takarakasai/namiashi-runner2/doc/motor_map.md

# モータ / ポート対応表

`robots/namiashi.toml` の内容をそのまま表にしたもの。**校正で値が変わったら
`misa-run check` の出力が最新**（あちらは設定から毎回生成している）。ここは
ベンチで手元に置く紙の代わり。

## CH348 の UART 割り当て

`nm_board/ch348/spec_rev2_0_0_asbuilt.md` §4 の as-built 確定値。

| UART | 役割 | I/F | コネクタ |
|:--:|---|---|---|
| 0 | LEG1 = **FL** | RS485 (U9) | J14 (1=B, 2=A) |
| 1 | LEG2 = **RL** | RS485 (U10) | J15 |
| 2 | LEG3 = **FR** | RS485 (U11) | J16 |
| 3 | LEG4 = **RR** | RS485 (U12) | J17 |
| 4 | ARMA（腕） | RS485 (U13) / TTL 切替 | J18 + CN3 |
| 5 | IMU | TTL 直結 | CN1 (1=+3.3V, 2=GND, 3=TX, 4=RX) |
| 6 | S.BUS | 反転 TTL (U15)、**受信専用** | CN2 (1=GND, 2=+5V, 3=RX) |
| 7 | ARMB（予備） | RS485 (U14) / TTL 切替 | J19 + CN4 |

> **訂正 (2026-08-21):** 本表は 2026-08-20 まで UART1=FR / UART2=RL と書いて
> いたが誤り。実機は **UART1=RL / UART2=FR**。articara で実測角を可視化し、
> 脚を手で動かして対応を突き合わせて判明した（`viz_live.md`）。
>
> J14..J17 が左列 → 右列に並ぶ基板なので、**左 2 本（FL, RL）を先に配線するのが
> 自然な取り回し**になる。コード側の既定値もこれに合わせた。
>
> **`LegSlot::ALL`（FL, FR, RL, RR）とは順序が違う**点に注意。あちらは
> `quadruped_gait::LegId::ALL` と一致させる必要があり `JointVec` の添字にも
> なっているので、UART 割り当てを位置で振ってはいけない。

**`/dev/ttyCH9344USB*` の番号は当てにしない。** 列挙順で決まるので物理 UART
番号とは無関係。アプリは ch9344 の `GETUARTINDEX` ioctl で引いている
（`misa-run ports` で対応が見える）。

## 脚モータ 12 軸（LKMTech MG4005）

共通: RS485 **2,000,000 baud** / torque_constant 未設定
（＝トルク API は電流 A のまま流れる）

**減速比は軸で違う。** hip / thigh は MG4005 内蔵の **10.0**、
**calf だけベルト駆動でプーリの歯数比 28:18 が上乗せされ、総減速比 15.5556**。
脚のなかで一番負荷がかかる軸なのでそう設計されている。
設定では `MotorConfig::gear_ratio` に軸個別で持つ（未指定なら共通値）。

> **歯数から計算すること。** 28/18 = 1.5555… を 1.55 と丸めると 0.36% ずれ、
> calf の端（±2.6 rad）で約 0.5° になる。歯数は整数で誤差が無いので、
> コード側も `CALF_PULLEY_TEETH = (28.0, 18.0)` の比で持っている。
>
> **訂正 (2026-08-21):** 当初 1.47（総減速比 14.7）としていたが誤り。
> 正しくは 28:18。差は 5.8% で、calf を −2.79 rad と読んでいた場合の
> 真値は −2.64 rad（**8.8° の違い**）。それ以前に採った calf の読み値は
> すべてこの分ずれている。

**符号（`sign`）は全軸 +1 ではない。**

| | hip (Roll) | thigh (Pitch) | calf (Pitch) |
|---|:--:|:--:|:--:|
| FL | +1 | +1 | +1 |
| RL | **−1** | +1 | +1 |
| FR | +1 | **−1** | **−1** |
| RR | **−1** | **−1** | **−1** |

**Roll は前後で、Pitch は左右で反転する。** 反転の軸が違うので、
左右対称だろうと決めてかかると外す。

**独立した 3 つの根拠が一致している**（2026-08-22 時点）:

1. 設計データ
2. 実機での目視確認（両後脚の Roll が逆、右脚 2 本の Pitch が逆）
3. `calib move` で 12 軸を 1 軸ずつ 5° 動かした実測（段階 5）

> **`calib move` は可動域の端にいると使えない。** 目標は可動域へクランプ
> されるので、端の外や近くにいると「5° 動かす」つもりが端まで一気に動く。
>
> 実測 (2026-08-22): RL hip が可動域の外（−75.9°、min は −60°）にいたため、
> 5° の指令が **15.9° の移動**になった。しかも「+ 方向へ動いたか」への答えは
> クランプの結果であって符号の証拠にならないのに、そのまま採用されかけた。
> 手で内側へ戻してやり直したところ、期待どおり −1 が出た。
>
> **Δ が 5.00° でなければ結果を捨てること。** 他 11 軸はすべて 5.00° だった。

> **訂正 (2026-08-21):** 本表は 2026-08-20 まで **1,000,000 baud** と書いていたが誤り。
> 実機は **2 Mbps**。初通電時の id スキャンが 4 脚とも「応答なし」になり、
> 電源・A/B 極性を疑って切り分けた末に判明した。
> 2 Mbps に直したところ 4 脚とも即座に `id 1, 2, 3` が応答した。

| # | 脚 | UART | コネクタ | 関節名 | kind | **RS485 id** | 可動域 [rad] | URDF effort [N·m] |
|---|---|:--:|---|---|---|:--:|---|---|
| 1 | FL | 0 | J14 | `FL_hip_joint` | hip | **1** | −0.785 … +1.05 | 1.5 |
| 2 | FL | 0 | J14 | `FL_thigh_joint` | thigh | **2** | −2.62 … +2.62 | 1.5 |
| 3 | FL | 0 | J14 | `FL_calf_joint` | calf | **3** | **−2.697 … +2.697** | 2.205 |
| 4 | RL | 1 | J15 | `RL_hip_joint` | hip | **1** | −0.785 … +1.05 | 1.5 |
| 5 | RL | 1 | J15 | `RL_thigh_joint` | thigh | **2** | −2.62 … +2.62 | 1.5 |
| 6 | RL | 1 | J15 | `RL_calf_joint` | calf | **3** | **−2.697 … +2.697** | 2.205 |
| 7 | FR | 2 | J16 | `FR_hip_joint` | hip | **1** | −1.05 … +0.785 | 1.5 |
| 8 | FR | 2 | J16 | `FR_thigh_joint` | thigh | **2** | −2.62 … +2.62 | 1.5 |
| 9 | FR | 2 | J16 | `FR_calf_joint` | calf | **3** | **−2.697 … +2.697** | 2.205 |
| 10 | RR | 3 | J17 | `RR_hip_joint` | hip | **1** | −1.05 … +0.785 | 1.5 |
| 11 | RR | 3 | J17 | `RR_thigh_joint` | thigh | **2** | −2.62 … +2.62 | 1.5 |
| 12 | RR | 3 | J17 | `RR_calf_joint` | calf | **3** | **−2.697 … +2.697** | 2.205 |

### 読むときの注意

- **id はバス内でのみ一意。** 4 バスとも `1, 2, 3` の繰り返しなので、id 単体では
  12 軸を区別できない。軸の identity は **(バス, id)** の組で、バス側が半分を
  担っている。取り違えの症状は「片脚だけ挙動がおかしい」になり、配線かソフトかの
  切り分けがしづらい。コネクタと id は必ずセットで確認すること。
- **hip の可動域は CAD から決めた運用制限**で、URDF の `<limit>` ではない。

  | 脚 | 可動域 |
  |---|---|
  | 左足 FL / RL | **−60° … +45°** |
  | 右足 FR / RR | **−45° … +60°** |

  > **メカ端まで振ってはいけない。** hip Roll のメカ端は非常に広く、そこまで
  > 振ると**ケーブルが破断しうる**。機械が止めてくれないので、ソフト側で
  > 先に止めるしかない。`calib range` で手測りするのも避けること
  > （端まで動かす作業そのものが危険）。
  >
  > **訂正 (2026-08-21):** URDF は左右が逆だった。大きさ（45° / 60°）は
  > 合っていたが割り当てが入れ替わっており、左足に右足の値が入っていた。
- ~~**`sign` と `zero_pose_rad` は全 12 軸まだ未校正**（+1.0 / 0.0 の推測値）。~~
  **`sign` は 2026-08-21 に確定**（上表、設計データ + 実機確認）。

  **`zero_pose_rad` はモデル角とモータ出力軸角のオフセット**
  （`q_model = sign * q_motor + zero_pose_rad`）。
  **12 軸すべて実機で確定済み (2026-08-22)。** hip / thigh は可動域の中心から、
  calf は突き当て位置から。設計データそのままの軸はもう無い。

  | 脚 | hip | thigh | calf |
  |---|---:|---:|---:|
  | FL | **+33.20°** | **+68.40°** | **−154.52338°** |
  | FR | **−34.11°** | **+68.35°** | **−154.52338°** |
  | RL | **+31.79°** | **+64.79°** | **−154.52338°** |
  | RR | **−31.83°** | **+63.91°** | **−154.52338°** |

  hip / thigh は**可動域の中心**から確定した (2026-08-22)。calf は突き当て基準。

  > **calf は突き当て位置が基準。** 電源 ON = 突き当て = `q_abs 0` なので、
  > オフセットは突き当ての モデル角そのもの。**可動域の下限と同じ値**になる。
  >
  > **訂正 (2026-08-21):** 当初の −160° は**二重に古い情報**で計算されていた
  > （旧減速比 14.7 + 旧突き当て角）。最新の可動域 ±154.52338° に合わせて
  > 置き直した。
  >
  > 突き当てが可動域より外側（使用範囲にマージンがある）なら、その分ずれる。

  > **thigh は前後で水平の定義が違う。可動域の都合による設計。**
  >
  > | | 水平のときのモデル角 |
  > |---|---|
  > | 前脚 FL / FR | **−π/2** |
  > | 後脚 RL / RR | **+π/2** |
  >
  > 前後の表示が π ずれていても異常ではない。**知らないと「片方が壊れている」
  > と誤診する。**
  >
  > **後脚の thigh は実機で補正した (2026-08-21)。** 水平のとき RL が +1.81、
  > RR が +1.91 と過大だったので、その分をオフセットから引いた。
  > 前脚は −1.57 で期待値どおりだったため無変更。
  > RL と RR で値が違う（53.29° / 47.57°）のは実測どおり。

  > **thigh 4 軸は可動域の中心から確定した (2026-08-22)。**
  >
  > | 脚 | 実測 min/max | 幅 | 中心 | zero_pose_rad |
  > |---|---|---|---|---|
  > | FL | −2.6214 / +2.5724 | 5.194 | −1.40° | **+68.40°** |
  > | FR | −2.5218 / +2.6651 | 5.187 | +4.11° | **+68.35°** |
  > | RL | −2.7860 / +2.3846 | 5.171 | −11.50° | **+64.79°** |
  > | RR | −2.8808 / +2.3102 | 5.191 | −16.35° | **+63.91°** |
  >
  > **前脚の左右が 0.06° で一致**（後脚は 0.88°）。手で動かした測定でこの一致は、
  > 方法が妥当であることの裏付けになる。
  >
  > **測定の前に 12 軸のマルチターンをリセットすること**（`calib clear-multiturn`
  > を伏せ姿勢で）。原点が揃っていないと軸ごとに基準が違う値になる。実際、
  > リセット前に測った FR は +72.45° で、リセット後は +68.35° と 4.1° 動いた。
  >
  > **「水平で目視」から求める方法は使わない。** articara の見た目で判断すると
  > 数度は容易にずれる。両端は物理的に決まった点なので、そちらを基準にする。
  >
  > **実測の幅は ±145° より 6〜7° 広い**（4 軸とも一貫、ばらつき 1.3° 以内）。
  > 手で押し込むと数度余分に入るためとみられる。**設定の可動域は ±145° のまま**に
  > してある。実測値まで広げると押し込んだ分まで指令できてしまう。
  >
  > **hip 4 軸をメカリミットの中心から確定した (2026-08-22)。**
  >
  > リミット出し部品を製作・取付し、メカ端まで振って測った。
  >
  > | 脚 | 実測 min/max | 幅 | 中心 | zero_pose_rad | 設計 ±34° との差 |
  > |---|---|---|---|---|---|
  > | FL | −1.9386 / +1.6264 | 204.26° | −8.94° | **+33.20°** | −0.80° |
  > | FR | −1.5968 / +1.9406 | 202.68° | +9.85° | **−34.11°** | +0.11° |
  > | RL | −2.0270 / +1.5641 | 205.75° | −13.26° | **+31.79°** | −2.21° |
  > | RR | −1.5437 / +2.0079 | 203.49° | +13.30° | **−31.83°** | −2.17° |
  >
  > **設計データの ±34° に 0.1〜2.2° で戻ってきた。** つまり
  > **8/21 の目視補正 (下記) が 10〜15° 外していた**ということ。thigh で
  > 「目視と可動域基準が 4° 食い違う」実績があり、hip も同様に疑っていたが、
  > 実際には thigh よりはるかに大きく外していた。
  >
  > **後脚の左右が 0.04° で一致**（前脚は 0.91°）。手で押し当てた測定で
  > この一致は、方法が妥当であることの裏付けになる。前後で 1.85° 違うのは
  > 実測どおりで、設計は 4 軸とも同値 (±34°) としていた。
  >
  > 前提は**メカ端が関節ゼロについて対称**であること。設計値と一致したことが
  > その裏取りになっている。
  >
  > **メカ端は新フレームで ±101〜103°。** 運用制限 (CAD の左 −60…+45° /
  > 右 −45…+60°) までの余裕は 41〜58° あり、**運用制限は変えない**。
  > メカ端まで振ってよいのはこの測定のときだけで、常用してはいけない
  > （ケーブル破断のリスク）。
  >
  > <details><summary>置き換えられた暫定値 (2026-08-21、目視基準)</summary>
  >
  > 設計データの ±34° を入れた状態で **表示が実際より過大**に見えたため、
  > 実際が 0° のとき表示が FL +0.17 / FR −0.17 / RL +0.27 / RR −0.27 rad を
  > 指しているとみなし、その分をオフセットから引いていた
  > （hip = FL +24.26° / FR −24.26° / RL +18.53° / RR −18.53°）。
  >
  > ```
  > q_model = sign * q_abs + zero_pose_rad
  > 表示が +0.17 過大 → zero_pose_rad から 0.17 を引く
  > ```
  >
  > **この判断が誤りだった。** articara の見た目で「0°」を決めたことが原因で、
  > thigh と同じ轍。**両端は物理的に決まった点なので、そちらを基準にする。**
  > </details>
  >
  > 補正量が 10〜15° と大きい。設計データの「伏せ姿勢」と、実際に電源を
  > 入れている姿勢が同じでない可能性がある。**thigh と calf は未補正**なので、
  > 同様のずれが残っているかもしれない。段階 6 の `calib zero` で 12 軸まとめて
  > 測り直すのが本筋。
  >
  > 前後で値が違う（24.26° / 18.53°）のは実機の実測どおり。左右は符号反転で対称。

  > **基準の性質が軸で違う。これが実測のずれ方を説明する。**
  >
  > | 軸 | 基準 | 再現性 |
  > |---|---|---|
  > | hip / thigh | **メカ端 2 点の中心**（`calib range`） | 機構が決めるので再現する |
  > | calf | **メカ的な突き当て**からのオフセット | 同上 |
  >
  > **3 軸とも機構が決める点を基準にしている。** 設計データの
  > 「伏せ姿勢での電源 ON」基準は、姿勢を人が作るので毎回変わり、実際に
  > hip で 10〜15°・thigh で 4〜16° ずれていた。**もう使わない。**
  > **calf の突き当て基準は触らない。**
  >
  > ### 電源 OFF/ON と「伏せ起動」
  >
  > MG4005 は**多回転**のアブソリュートを持たないので、**電源 ON した瞬間の
  > 姿勢が `0x92` のマルチターン角 0 になる**。`zero_pose_rad` はその
  > **電源投入姿勢のモデル角**であり、**毎回「伏せ姿勢」で電源を入れる**
  > という運用がそのまま回転数の解決になっている。
  > アプリの再起動では動かない — 基準はモータ側にある。
  >
  > **したがって電源を切ってもゼロ点は死なない。** 死ぬのは伏せ姿勢を
  > 再現しなかったときだけ。メカ作業で電源を落とすのは通常の運用。
  >
  > **精度は伏せ姿勢の再現性そのもの。** 今回の hip 実測が設計の伏せ姿勢
  > ±34° に対して 0.1〜2.2° に収まったので、再現性はその程度。
  > **その誤差がそのままゼロ点の誤差になる。**
  >
  > メカ端を測る方法の利点は、伏せ姿勢に頼らずに**いつでも測り直せる**こと。
  > 両端は物理的に決まった点なので、姿勢を目視で作る方法と違って再現する。
  >
  > ### `0x94`（単回転絶対角）へ移す余地
  >
  > `0x94` は ROM のエンコーダゼロが基準なので**電源をまたいで一致する**
  > （`calib single-turn` で読める）。ここへ移せば、
  >
  > - 必要な姿勢精度が「1 モータ回転の半分」まで緩む
  >   （hip/thigh **±18°**、calf **±11.6°**）
  > - 精度は姿勢の再現性ではなく**エンコーダ由来**になる
  >
  > 何回転目かの解決には依然として既知の姿勢が要るが、要求が桁違いに緩い。
  > **未着手。** 移すなら、選んだ回転が可動域に収まらないときは起動を止める
  > こと（黙って 36° ずれた姿勢で立ち上がるのが一番危ない）。

- **モータ id は設計データを採用していない。** 設計は FL 10-12 / RL 13-15 /
  FR 20-22 / RR 23-25 だが、**これは 4 バス化より前の資料**で、実機は 4 バスとも
  `1, 2, 3`（段階 2-2 のスキャンで確認）。上表のとおり 1, 2, 3 が正。

- **可動域の出所は軸で違う。**

  | 軸 | 可動域 | 出所 | `calib range` で測る？ |
  |---|---|---|---|
  | hip | 左 −60…+45° / 右 −45…+60° | **CAD**（ケーブル保護の運用制限） | メカ端は ±101〜103°。**運用では端まで振らない** |
  | thigh | **±145°**（4 軸共通） | **実測済み** | 済 |
  | calf | ±154.52338° | **設計のメカ端** | **測らない。** 手測りは必ず狭くなる |

  calf を手で測ると (a) 突き当てまで押し込めない (b) `--margin` がさらに引かれる、
  で今より狭い値になり、`start` ポーズがクランプされてしまう。

  **calf だけ可動域が違う。** 2026-08-21 の設計変更で **±154.52338°
  (±2.6969 rad)**。thigh の ±2.62 rad (±150.11°) と混ぜないこと。

  > **解消済み (2026-08-22)。全 6 ポーズが可動域内。** 段階 7-1 で
  > `.misa` の全ポーズを設定の可動域と突き合わせて確認した。
  >
  > | ポーズ | 最小余裕 | どの軸 |
  > |---|---|---|
  > | `extend_full` / `extend` / `standby` | +45.00° | hip |
  > | `constrain` | +39.93° | calf |
  > | **`start`** | **+10.00°** | 前脚 calf (−144.52°) |
  > | **`constrain_2`** | **+5.55°** | calf (−148.97°) |
  >
  > `start` の +10° はメカ端から 10° の余裕を持たせる設計方針どおり。
  > **`constrain_2` の +5.55° が一番きつい**ので、calf の可動域を今後
  > 狭めるならここが最初に引っかかる。
  >
  > かつて「前脚 calf −162° が +7.48° 超過」と記録していたが、その後
  > ポーズ側が −144.52° に更新されて解決している。

## 異常ビット（`errorState`）

マニュアル §1 の `errorState` は 1 ビットずつ意味が違い、**対処もまるで
別物**。`misa-run run` は日本語で出す（生値だけでは判断できない）。

| bit | 値 | 意味 | 対処 |
|---|---|---|---|
| 0 | `0x01` | **低電圧保護** | 電源電圧を確認。電流制限に当たっていないか |
| 1 | `0x02` | 高電圧保護 | 回生。減速を緩める |
| 2 | `0x04` | ドライバ過熱 | 冷えるまで待つ |
| 3 | `0x08` | モータ過熱 | 同上 |

**起動時に自動クリアはしない。**

> マニュアル §2: *the error flags cannot be cleared while the motor state
> has not yet returned to normal.*
>
> つまり**原因が残っている間はクリアコマンド自体が効かない**ので、自動で
> 投げても無意味。仮に効く場合でも、自動クリアは「生きている異常を握り
> 潰して動き出す」ことになる。低電圧のまま起立させればトルクが出ずに
> 崩れるか、また保護に入る。

消すのは人が原因を潰したと判断したときだけ:

```sh
./target/release/misa-run calib clear-error [--leg FL]
```

`0x9B` の応答は**「消した後の状態」**であって成功フラグではないので、
返ってきたフラグを見て判定している。

### 低電圧保護は `0x9B` で解除できる【解決】

**2026-08-22。** 段階 8 の確認中に過負荷で低電圧保護 (`0x01`) に入る事象が
複数回起きた。**結論を 5 回変えた**ので、確定した事実と、外した見立ての
理由を残す。

#### 確定した挙動

**クリアコマンド (`0x9B`) は効く。待っても消えない。**

| 時刻 | 操作 | 結果 |
|---|---|---|
| 12:18:03〜12:21:39 | **`--dry-run` のみ（3.5 分）** | **消えない** |
| 12:21:45 | **クリアを送信** | |
| 12:22:52 | `legs` | 異常ログ 1 行も無し = **消えている** |
| 12:22:58 | `--dry-run` | **12 軸すべて正常** |

電圧は終始 19.8 V。**電圧を上げる必要も、`0x07` による再起動も要らない。**
バッテリ運用でも `0x9B` で復帰できる。

#### なぜ 5 回も外したか — **表示のバグだった**

`0x9B` の応答は **「コマンドを受けた時点の状態」** を返す。マニュアル §2 は
「応答は status1 と同じ」としか書かず、消す前か後かに触れていない。
**こちらが「消した後」と決めつけて、応答をそのまま状態として保存していた。**
その結果「クリア後」に異常が残って見え、毎回モータ側の物理現象として
説明しようとした。

外した見立て（すべて根拠不足）:

1. 「電源が壊れている / 電流制限に張り付いている」→ 19.8 V は設計値
2. 「6S LiFePO4 はこのドライバでは使えない」→ **16 V でも歩けた**
3. 「フラグは現在状態で、電圧が戻れば自動で消える」
4. 「リセット閾値は 19.9〜20.9 V のヒステリシス」
5. 「時間経過で自然に解除される」→ **3.5 分待っても消えない**

**分かれ目は毎回同じ。** 「同じ電圧で正常な軸と異常な軸が混在する」
「RR thigh だけ毎回消える」という観測は**最初から表示バグを示唆していた**
（定期 status 読みが 1 秒に 1 軸ずつ巡回するので、クリア直後に当たった軸
だけが本当の状態を見せていた）。それをモータの個体差として説明し続けた。

> **自分が書いた表示を疑わなかったのが原因。** 実機の挙動が奇妙なとき、
> 観測系のバグを先に疑うこと。

対策として、**クリアを送った直後に `0x9A` で読み直す**ようにした
（`BusRequest::ClearError`）。応答は信用しない。

#### 電圧の余裕

| 電圧 | 結果 |
|---|---|
| 19.8 V | 終日正常動作（6S LiFePO4 を想定した設計値） |
| 17.6 V | 保護は出ない |
| **16 V** | **立脚まで到達し、歩容が 1 秒動いた** |

**トリップ閾値は 16 V より下。19.8 V の常用には十分な余裕がある。**

**掃引はこれ以上しない。SBC (A7Z) が同じ電源から給電されている。**
下げ続けると DC-DC が入力下限を割って SBC が落ち、SD カードを壊しうる。
制御が消えて 12 軸が脱力する方が、モータの保護よりはるかに悪い。

#### 本当の問題はストール時の突入電流

16 V でも落ちないのだから、過負荷時は**もっと深いところまで瞬間的に
沈んでいる**。脱調や突き当てでモータが大電流を引き、電源が電流制限
(5 A) に落ちてレールが崩壊する。

**復帰できることは分かったが、復帰は解決ではない。** 試合中に 12 軸が
同時にトルクを失えばその時点で倒れる。**落とさないことが目的。**

- **ストールを検知して指令を止める**（追従誤差の監視。第 1 段は実装済み、
  状態表示に `追従最大=` として出る。上限で頭打ちにする第 2 段は未実装）
- ソフト側でトルク / 速度の上限を絞る
- SBC の電源系統を分離する（**本番が近いため保留中**）

> **本番のバッテリは電流を制限しない。** 電圧は落ちにくくなるが電流は
> 青天井になるので、ストール時の発熱・損傷はむしろ悪化する。

RS485 のマニュアルに閾値を読む・書くコマンドは無い（§18/19 は PID と
加速度のみ）。

### `0x07`（モータ再起動）【実装済み・出番は無くなった】

低電圧保護が `0x9B` で解除できると分かったので、**復帰目的では要らない**。
原点を失う代償に見合わない。

以下は「電源再投入をバスから起こしたい」別の用途のために残す。

`misa-run calib restart [--leg FL] [--joint calf]` で試せる。
**必ず伏せ姿勢で。** 原点がリセットされるので、伏せ以外だと 12 軸の
ゼロ点が飛ぶ。前後の異常状態と Δq(model) を並べて出す。

**まだ実行していない。** トリップさせるには深く沈める必要があり、
SBC を巻き込むため。

> **フレームの組み方は CAN マニュアルから導けない。**
>
> | | CAN 上の見た目 | RS485 の実際 |
> |---|---|---|
> | `0x92` | `DATA[0]=0x92`, `DATA[1..7]` ヌル | `CMD[3] = 0x00`（データ無し） |
> | `0x95` | `DATA[0]=0x95`, `DATA[1..7]` ヌル | **`CMD[3] = 0x07` + ゼロ 7 バイト** |
>
> CAN では同形なのに RS485 では違う。**ここを取り違えて `0x95` で
> マルチターンカウンタを 2 回壊した**（2026-08-21）。
>
> `0x07` は `CMD[3] = 0x00` で送る。RS485 マニュアルの引数なしコマンドは
> Motor off/run/stop・状態読み・エラークリア・多回転読み・単回転読みまで
> **すべて `0x00`** で、`0x95`（§24）だけが唯一の例外。

## 可動域を逸脱したときの扱い【未解決】

**制御中に外力を受けると、上表の可動域を超えることがある。** 指令は
`min_rad`/`max_rad` にクランプされるので**こちらから超えることはない**が、
押された・転んだ場合は超えうる。

**超えた状態で脱力させるのは危険。** 特に hip は、メカ端まで余裕がある一方で
ケーブルが先に限界を迎える。脱力するとそのまま外力に任せることになり、
自力で戻れない。

現状の挙動:

| きっかけ | 挙動 | 逸脱時に安全か |
|---|---|---|
| S.BUS 受信断・フェイルセーフ | 速度 0・その場起立（**脱力しない**） | 比較的よい。姿勢を保とうとする |
| **`Ctrl-C`** | **全軸脱力** | **危うい。** 逸脱したまま力が抜ける |
| モータ電源 OFF | 脱力 | 同上 |

`Ctrl-C` の脱力は「暴走したら力を抜く」という発想で、それ自体は正しい。
しかし**逸脱時にはむしろ戻してから抜きたい**。両立させるなら、脱力の前に
可動域内へ戻す動作を挟むことになるが、暴走時にそれをやると危険が増す。
**トレードオフであり、決めきれていない。**

判断の材料になる実測がまだ無い（段階 7 以降で逸脱が実際に起きるか）。
それまでは**脚を浮かせた状態でしか運転しない**という運用で回避する。

## 腕

`arm_pitch_joint` は MG4005 ではなく RC サーボ。**受信機直結**で、アプリは
駆動しない（プロポ CH9 から角度を観測するだけ）。品種は未定。

| 項目 | 値 |
|---|---|
| 可動域 | −2.3 … +0.85 rad（URDF `<limit>`） |
| effort | 6.865 N·m |
| 観測チャンネル | S.BUS CH9（`teleop.arm`） |
