takarakasai/namiashi-runner2/sim/tests/fixtures/namiashi/meshes/calf.stl

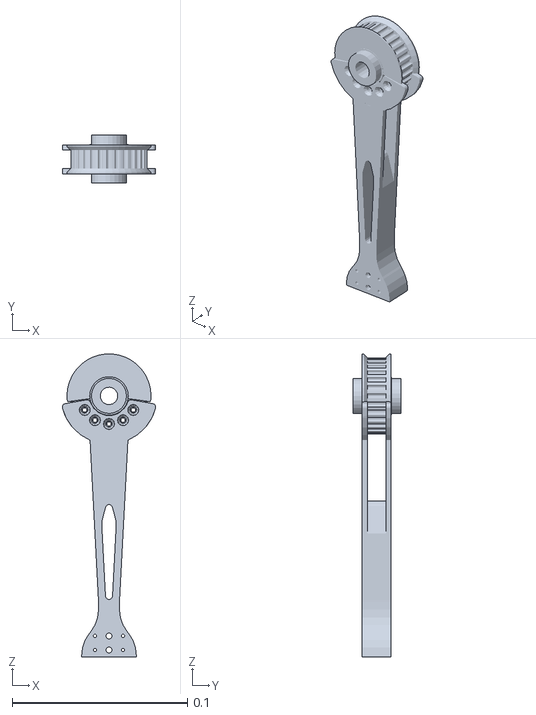
[picture p1: CAD file, 2026-09-11]
sim/tests/fixtures/namiashi/meshes/calf.stl
0.0533 x 0.0274 x 0.173
