takarakasai/namiashi-runner2/sim/tests/fixtures/namiashi/meshes/arm.stl

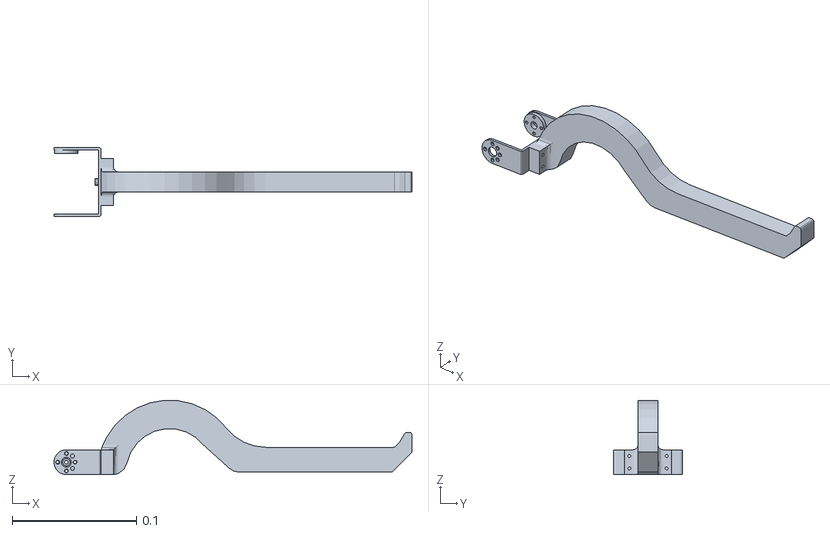
[picture p2: CAD file, 2026-09-11]
sim/tests/fixtures/namiashi/meshes/arm.stl
0.288 x 0.0556 x 0.0597
