takarakasai/namiashi-runner2/sim/tests/fixtures/namiashi/meshes/thigh.stl

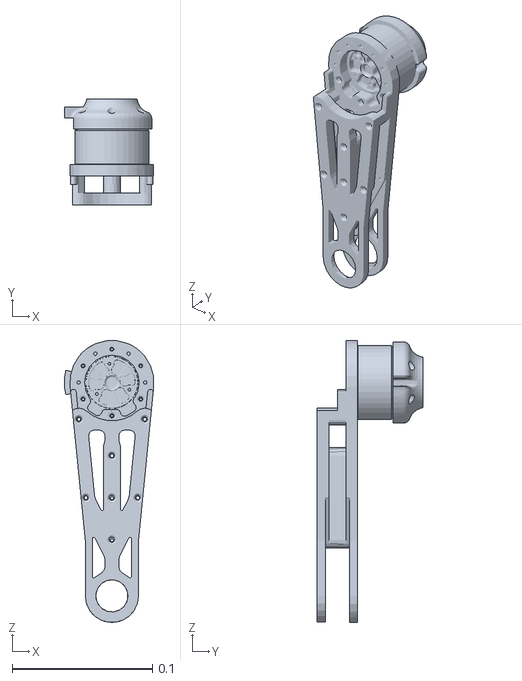
[picture p3: CAD file, 2026-09-11]
sim/tests/fixtures/namiashi/meshes/thigh.stl
0.0639 x 0.0755 x 0.201
