takarakasai/namiashi-runner2/sim/tests/fixtures/namiashi/meshes/trunk.stl

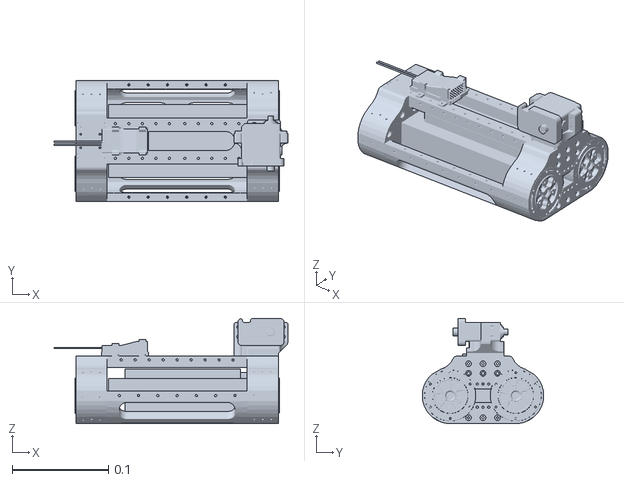
[picture p4: CAD file, 2026-09-11]
sim/tests/fixtures/namiashi/meshes/trunk.stl
0.243 x 0.125 x 0.109
