takarakasai/namiashi-runner2/sim/tests/fixtures/namiashi/meshes/hip.stl

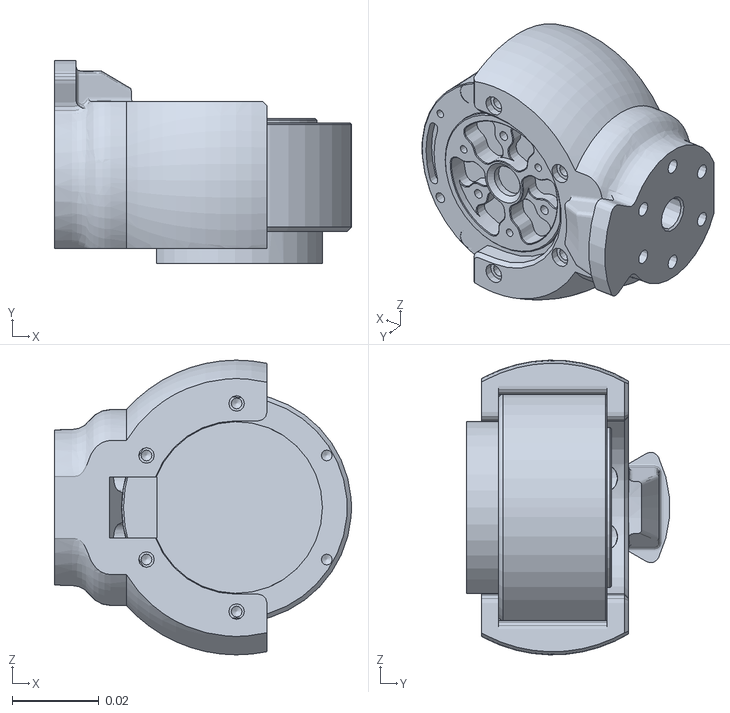
[picture p5: CAD file, 2026-09-11]
sim/tests/fixtures/namiashi/meshes/hip.stl
0.0685 x 0.0468 x 0.068
