takarakasai/namiashi-runner2/sim/src/wbc_harness.rs

//! Shared WBC/MPC MuJoCo simulation harness for namiashi.
//!
//! Promoted out of `tests/wbc_walk.rs` so a proper binary (whose `fn
//! main()` runs on the real process main thread, required by
//! `mujoco-rs`'s `winit`-based viewer -- `cargo test`'s harness always
//! runs test bodies on a worker thread, which `MjViewer::launch_passive`
//! cannot tolerate) can call the exact same, already-validated
//! `run_wbc_sim` pipeline that every WBC/MPC measurement in
//! `tests/wbc_walk.rs` is built on, instead of a second, drifting
//! reimplementation. `tests/wbc_walk.rs` re-imports everything here via
//! `use namiashi_sim::wbc_harness::*;` -- nothing about its ~85 tests'
//! behavior changes, only where the code they call lives.

use std::path::PathBuf;

use articara::gait::{
    auto_detect_centroidal_mpc_config, auto_detect_kinematics_config,
    auto_detect_srbd_mpc_config, GaitController, DEFAULT_FOOT_LINKS,
};
use articara::mjcf::{GroundPlaneCfg, MjcfExportOptions, StaircaseCfg};
use articara::mujoco_sim::MujocoSim;
use articara::rbd::model::ActuatorMode;
use articara::robot::RobotModel;
use articara::wbc_pipeline::WbcPipeline;
use nalgebra::Vector3;
use quadruped_gait::wbc;
use quadruped_gait::{
    solve_leg_ik, ContactDrivenPhase, GaitConfig, GaitMode, GaitType,
    KinematicsConfig, LegIkSolution, VelocityCmd,
};

pub fn namiashi_misa() -> PathBuf {
    namiashi_misa_named("namiashi.misa")
}

/// The model every test runs on unless it says otherwise.
///
/// `namiashi_meas.misa` is the 現物合わせ result (2026-09-13): 3.295 kg
/// measured total, 611 g measured per leg, and -- the part the 3p3 variants
/// had to guess -- the MEASURED motor placement (MG4005 150 g each: the
/// hip-roll motor on the trunk, the thigh motor on the hip link, the knee
/// motor at the thigh's proximal end). It also carries the knee's 9:14
/// reduction referred through and the calibrated calf range (+-2.697 rad).
/// Generated by `remass_meas.py` in `models/namiashi/` (the
/// namiashi_description submodule); the copy here keeps this crate
/// standalone.
///
/// The `3p3_{prop,hip}` variants remain as the two bracketing hypotheses
/// from before the placement was known. The recorded prop-vs-hip
/// comparisons in `wbc_walk.rs` pin them explicitly and stay meaningful;
/// the measured distribution sits between them (motor mass proximal like
/// `hip`, but a motor on the thigh too, which neither variant has).
pub const DEFAULT_MISA: &str = "namiashi_meas.misa";

/// The shipped `namiashi.misa` came from a CAD export totalling 2.400 kg with
/// 36% of that in the legs. The built robot is 3.3 kg with 600 g per leg --
/// 73% in the legs. `rescale_mass.py` in the same directory regenerates the
/// corrected models; `_hip` puts the extra mass at the hip where the motors
/// are, `_prop` spreads it along the leg as the CAD distribution implies.
pub fn namiashi_misa_named(file: &str) -> PathBuf {
    PathBuf::from(env!("CARGO_MANIFEST_DIR"))
        .join("tests")
        .join("fixtures")
        .join("namiashi")
        .join(file)
}

/// Same seeding logic as `gait_walk_stability`. Keeps the legs out of
/// their q=0 fully-extended kinematic singularity at sim start.
pub fn seed_joint_positions_from_kinematics(
    robot: &mut RobotModel,
    kin: &KinematicsConfig,
) {
    for leg_kin in [&kin.fl, &kin.fr, &kin.rl, &kin.rr] {
        let target = leg_kin.nominal_foot_body;
        let sol = solve_leg_ik(leg_kin, target, false);
        let LegIkSolution::Reached { hip, thigh, calf } = sol else {
            panic!(
                "{:?}: nominal_foot_body unreachable",
                leg_kin.leg
            );
        };
        for (joint_name, q_ik, sign) in [
            (&leg_kin.hip_joint, hip, 1.0),
            (&leg_kin.thigh_joint, thigh, -1.0),
            (&leg_kin.calf_joint, calf, -1.0),
        ] {
            let Some(&ji) = robot.joint_map.get(joint_name.as_str()) else {
                continue;
            };
            robot.joint_positions[ji] = q_ik * sign;
        }
    }
}

/// Per-tick sample. We track `total_fz_world` (Σ contact-force z over
/// all contacts) so the static-balance test can compare it with
/// `m · g` after the burn-in window.
#[derive(Debug, Clone, Copy)]
pub struct WbcSample {
    pub t: f64,
    /// The opponent's `[x, y, z, up]`, or `None` when the scene has none.
    /// `up` is its trunk's own +z in world coordinates.
    pub foe: Option<[f64; 4]>,
    pub body_x: f64,
    pub body_z: f64,
    pub roll: f64,
    pub pitch: f64,
    pub total_fz_world: f64,
    /// Per-foot normal force (N), FL/FR/RL/RR. Contact state is what
    /// distinguishes a gait that is walking from one that is shuffling, and
    /// the original four tests could not see the difference -- they checked
    /// trunk height and net displacement only.
    pub foot_fz: [f64; 4],
    /// Per-foot fore-aft contact force (N), body-frame x. Where propulsion
    /// actually comes from: with a position servo on the stance legs the body
    /// is dragged forward kinematically by the foot sweep, but with them at
    /// kp=0 the only thing left is this.
    pub foot_fx: [f64; 4],
    /// Fore-aft force the MPC planned and the WBC's QP settled on, heading
    /// frame. The ratio of the two is how much of the plan is getting
    /// through, which is the question "is the MPC load-bearing" made
    /// measurable on every run instead of by hand.
    pub mpc_fx: f64,
    /// Vertical component of the same plan. A controller supporting a 3.3 kg
    /// robot must plan about +32 N; anything near -32 is a sign convention,
    /// not a control error, and the two are worth telling apart before
    /// chasing the latter.
    pub mpc_fz: f64,
    pub wbc_fx: f64,
    pub body_y: f64,
    pub yaw: f64,
    /// Carried per-sample only so `report_walk_cmd` can size its averaging
    /// window in whole gait cycles without every call site threading it.
    pub cycle_period_s: f64,
    /// |applied torque| / that joint's `effort` limit, per joint. A joint at
    /// 1.0 is clamped: the commanded torque is not the torque being produced,
    /// and the modelled controller is not the controller running.
    pub tau_frac: [f64; 12],
    /// |applied torque| in N*m. Kept alongside `tau_frac` because the peak
    /// and the continuous rating are different numbers and only the peak is
    /// in the model.
    pub tau_nm: [f64; 12],
    /// |joint velocity| / that joint's rated `velocity`. The knee's rating
    /// drops to 21.5 rad/s once its 9:14 reduction is referred properly, and
    /// `mujoco_sim` brakes overspeed with a torque added *before* the effort
    /// clamp -- so a joint that is too fast shows up as a joint that is out
    /// of torque, which is a different problem with a different fix.
    pub qd_frac: [f64; 12],
    /// Which legs the gait schedule had in stance this tick. Saturation means
    /// two different things depending on it -- a clamped stance joint is a
    /// robot that cannot hold itself up, a clamped swing joint is a leg that
    /// cannot be thrown fast enough -- and the fixes are unrelated.
    pub stance_mask: [bool; 4],
}

/// Threshold for "trunk has fallen". Below this z, the body has either
/// tipped over or sunk through the ground. Same value as
/// `gait_walk_stability`.
pub const TRUNK_Z_FALL_THRESHOLD_M: f64 = 0.18;

/// Which actuator interface the leg joints are driven through.
///
/// The target hardware for namiashi is the LKMTech MG4005, which has no MIT
/// mode: the CAN protocol offers closed-loop position, closed-loop speed, and
/// closed-loop iq. So the position-plus-torque-feedforward path this file has
/// used throughout -- which is what a Unitree-style `(q, dq, kp, kd, tau)`
/// frame gives you -- is not available as such.
///
/// Speed mode is the first choice over iq for a reason worth writing down:
/// torque mode puts the entire stabilising loop on the host, so host rate and
/// bus latency set the stability margin directly. Position and speed modes
/// close a fast inner loop inside the driver, and the host only has to be
/// fast enough to shape the trajectory.
#[derive(Debug, Clone, Copy, PartialEq)]
pub enum Actuation {
    /// Joint position target plus the WBC's torque feedforward -- everything
    /// in this file before the MG4005 was chosen. Not available on that part.
    PositionTorque,
    /// Joint velocity command only, as a speed-mode driver takes.
    ///
    /// `qd_des = dq*/dt + k_track * (q* - q)`. The feedforward alone would
    /// leave position free to drift, since a speed loop has no position
    /// feedback of its own; `k_track` is the outer position loop the host has
    /// to supply. `loop_kv` stands in for the driver's own speed-loop
    /// stiffness -- the model's `actuator_kv` of 1.2 is a position-mode
    /// damping value and would need 1.25 rad/s of error to reach the 1.5 N*m
    /// limit, which is not what a real speed loop does.
    Velocity { k_track: f64, loop_kv: f64, loop_ki: f64 },
    /// Speed mode with the driver modelled as an ideal velocity source,
    /// limited only by torque. The right abstraction for a loop that closes
    /// at 8-16 kHz against a host at a few hundred: from the host's side it
    /// tracks whatever it is asked for, until the motor runs out.
    VelocityIdeal { k_track: f64 },
    /// Raw joint torque, as a closed-loop-iq driver takes. The driver holds no
    /// position or velocity loop at all, so the host has to supply the whole
    /// thing: `tau = kp*(q* - q) + kd*(0 - qd) + tau_wbc`.
    ///
    /// Numerically identical to the position path if the host computes that
    /// PD at the same rate -- which is the point. What differs on hardware is
    /// *where* the loop runs. A speed-mode driver closes its inner loop
    /// internally on fresh encoder data at several kHz whatever the host is
    /// doing; in torque mode there is no inner loop, and the last torque the
    /// host sent is held until the next one arrives. `WbcParams::host_rate_hz`
    /// is what makes that difference visible.
    Torque { kp: f64, kd: f64 },
    /// `legged_control`'s actual low-level command, read off
    /// `legged_controller.cpp:142`:
    ///
    /// ```text
    /// setCommand(pos_des, vel_des, 5, 3, torque)
    ///     -> tau = kp*(pos_des - q) + kd*(vel_des - qd) + torque
    /// ```
    ///
    /// Three things this file has been getting wrong at once. The gain is 5,
    /// not 100 -- a twentieth. It is uniform, with no stance/swing split. And
    /// the damping term tracks a *velocity target* rather than damping toward
    /// zero, so it does not fight the swing it is supposed to be producing.
    ///
    /// `pos_des` there comes from the MPC's optimised state rather than an IK
    /// trajectory, which this does not reproduce -- the trajectory is still
    /// the gait controller's. So this is half the difference, and worth
    /// measuring before deciding whether the other half is needed.
    LeggedControl { kp: f64, kd: f64 },

    /// Stance legs pure torque, swing legs position-tracked.
    ///
    /// That stack sends Unitree's `(q, dq, kp, kd, tau)` with `kp = kd = 0`
    /// on stance legs, so the WBC's contact force *is* the joint torque and
    /// nothing else acts on them; swing legs get position gains because they
    /// are tracking a trajectory, not producing a force.
    ///
    /// Every result in this file has instead run kp=100 on all twelve joints
    /// with the WBC's torque added as feedforward. Under a stiff position
    /// servo tracking an IK trajectory, a force allocation is a small
    /// perturbation -- which is the obvious candidate for why four separate
    /// measurements have found the MPC not to matter here while it plainly
    /// does in legged_control.
    TorqueLeggedControl {
        swing_kp: f64,
        swing_kd: f64,
        /// Position gain on stance legs. `legged_control` uses 0 -- the
        /// WBC's contact force is the whole command. 100 is what this file
        /// has run throughout, and at that value the servo supplies the
        /// propulsion and the WBC only trims it. The interesting question is
        /// whether anything in between hands over cleanly.
        stance_kp: f64,
        stance_kd: f64,
        /// Scale on an explicit `h(q, q̇)` bias feedforward -- gravity plus
        /// Coriolis, not gravity alone. 0 leaves it to the WBC, whose `tau`
        /// solves the full equation of motion and should already carry it;
        /// 1 adds the whole thing. Measured rather than reasoned about,
        /// because at a static stand `tau_wbc` on a stance leg is
        /// (-0.369, +0.008, +0.559) against a leg-gravity of (+0.074, +0.048,
        /// -0.033) -- the support load dwarfs the bias, so a duplicate is a
        /// 10-20% error rather than a doubling, and the sign of its effect is
        /// not obvious.
        bias_ff: f64,
    },
}

/// What the controller is told about its own velocity.
#[derive(Debug, Clone, Copy, PartialEq)]
pub enum VelObs {
    /// Simulator ground truth -- what every result in this file was measured
    /// with, and what no robot has.
    Truth,
    /// Nothing. Both the MPC's state feedback and the WBC's SRBD state see a
    /// stationary robot.
    Zero,
    /// The commanded velocity, i.e. open loop: no velocity sensing at all,
    /// the controller simply believes it is doing what it was asked.
    Command,
    /// Truth plus a constant error, in m/s. Stands in for the drift an
    /// IMU-only estimate accumulates.
    Bias(f64, f64),
    /// Truth delayed by this many seconds.
    Lag(f64),
}

/// Capture-point footstep gain, seconds.
///
/// This was zero for most of this file's history, and that was right at the
/// time: at the library's 0.05 the 0.295 m stance overshot by 20%, drifted
/// sideways at 0.145 m/s and yawed at 2.34 deg/s, and zero fixed all three.
///
/// Every condition that was measured under has since changed -- the stance
/// dropped 6 cm, the actuation moved to a speed- or torque-mode driver, the
/// host went to 400 Hz -- and, more to the point, it was measured with
/// nothing disturbing the robot. Footstep feedback has nothing to do on flat
/// ground at a constant command; it can only add noise there. That is the one
/// condition under which its value cannot be judged.
///
/// With a push test to judge it by, a small gain is better on both counts
/// (Trot, speed mode, 400 Hz):
///
/// ```text
///     k        nominal   yaw drift      push survival
///     0.000       90%    +5.28 deg/s      5 of 8
///     0.015       97%    +0.85            6 of 8
///     0.030      102%    +1.31            6 of 8
///     0.050      106%    +0.11            6 of 8
/// ```
///
/// 0.015 rather than 0.030 or 0.050 because the recovery is the same at all
/// three and the walking is not: on the regression's own path over 25 s,
/// 0.030 overshoots Trot to 115% where 0.015 sits at 107%.
///
/// Still far below the library's 0.05 and further below the LIP value
/// sqrt(h/g) = 0.155 for this stance. See `namiashi_capture_gain_low_side`
/// for why that formula does not apply here.
/// Asset name for the ring heightfield; shared by the `<hfield>`
/// declaration, the `<geom>` that references it and the runtime fill, so
/// the three cannot drift apart.
pub const RING_HFIELD: &str = "kawasaki_ring";

/// Name prefix on the opponent's bodies, so `foe_trunk` and friends can be
/// asked about without colliding with the robot's own names.
pub const OPPONENT_PREFIX: &str = "foe_";

pub const NAMIASHI_CAPTURE_GAIN_S: f64 = 0.015;

/// Continuous torque rating, N*m, hip and thigh. The knee's 9:14 reduction
/// scales it the same way its peak is scaled.
///
/// `effort` in the model is the *peak* (2.5 N*m, 3.889 at the knee) and
/// MuJoCo clamps to it, so exceeding the continuous rating is invisible
/// there: a gait that sits at 2 N*m for a whole run never clamps and still
/// cooks the motor. Reported separately for that reason.
pub const NAMIASHI_RATED_TORQUE_NM: f64 = 1.0;

/// How far below the harness's original nominal stance every run now sits.
///
/// The file spent its whole history at one height, ~0.295 m, and
/// `namiashi_trunk_height_sweep` shows that was not a neutral choice. All
/// three gaits walk at 0, 2, 4 and 6 cm of crouch -- tracking stays 98-103%
/// and trunk z lands within a millimetre or two of target -- but crouching
/// rotates the leg Jacobian, so the same foot force gets split differently
/// between thigh and knee:
///
/// ```text
///     Trot   thigh 26.7 -> 10.7 %    calf  6.0 -> 17.0 %
///     Walk   thigh  6.3 ->  5.3 %    calf 11.3 ->  1.9 %
///     Crawl  thigh  3.4 ->  2.1 %    calf  9.8 ->  0.5 %
/// ```
///
/// 6 cm is the baseline because the thigh is the joint that actually binds --
/// it was clamped at its 1.5 N*m limit for a quarter of every Trot run, and
/// `mujoco_sim.rs:1121` does that silently -- and crouching more than halves
/// it. Walk and Crawl get it nearly free; their knee saturation all but
/// disappears and nothing else moves.
///
/// Trot pays for it. Its knee saturation nearly triples, and peak roll goes
/// from 2.8 deg to 5.3. That is a deliberate trade, not an oversight: 17% on
/// a 2.3 N*m knee is a better place to be than 27% on a 1.5 N*m thigh.
pub const NAMIASHI_STANCE_DROP_M: f64 = 0.06;

/// Minimum forward displacement during the walking window — the same
/// 4 cm threshold the gait stability test uses.
pub const MIN_DISPLACEMENT_M: f64 = 0.04;

/// How much of the tail of a static-stand run the gravity-balance average
/// covers.
pub const STATIC_AVG_WINDOW_S: f64 = 0.5;

/// Proprioceptive mid-swing collision recovery.
///
/// `namiashi_staircase_5cm_swing_clearance_sweep` ruled out swing-height
/// alone: raising it up to 3x flat-ground clearance still tips the robot
/// over on the first riser. But the diagnostic stream already carries a
/// clean signal for the moment of the collision itself -- swing FK error
/// (measured foot position vs. the open-loop swing target, in body frame)
/// spikes to ~0.09 m the instant a foot catches the riser, against a
/// flat-ground ceiling of ~0.05 m -- roughly 1.4 s before the yaw-rate
/// runaway that actually causes the fall. That is real lead time, and the
/// signal needs no new sensor: joint encoders plus the swing target the
/// gait controller already computes are enough.
///
/// This is the reflex built on that signal: when a swinging leg's FK error
/// crosses `trigger_m`, stop tracking its open-loop target and instead drive
/// straight up by `lift_m` from wherever the foot actually is -- "back off
/// and go over it" -- until the error falls back under `resume_m` (hysteresis
/// so it does not chatter at the threshold), at which point it resumes
/// tracking the normal swing trajectory.
#[derive(Clone, Copy, Debug)]
pub struct ContactReflexCfg {
    pub trigger_m: f64,
    pub resume_m: f64,
    pub lift_m: f64,
    /// While any leg is `reflex_active`, pass `dt=0` to `gc.tick()` instead of
    /// the real host period, freezing every leg's phase together rather than
    /// just overriding the disrupted leg's target.
    ///
    /// Without this, the other three legs' schedule keeps advancing on the
    /// gait's single shared phase clock while the disrupted leg is still
    /// fighting the obstacle -- so by the time it resolves, the rest of the
    /// gait already expects it to have been in stance for however long the
    /// reflex took, i.e. the robot is trying to balance on however many legs
    /// actually landed on schedule, not however many the gait *thinks* are
    /// down. That desync, not the collision itself, is the leading
    /// suspect for why the first two reflex attempts (lift from current
    /// position; lift the nominal target) both still ended in a collapse.
    pub freeze_phase_during_reflex: bool,
}

/// Perception-informed swing height (and, with `horizontal_margin_m > 0`,
/// touchdown placement): the "would knowing the terrain help at all"
/// question, tested in the cheapest honest way before building a real
/// sensor or a terrain-aware MPC cost term.
///
/// Every reflex variant in `ContactReflexCfg` reacts *after* a foot has
/// already caught the riser -- proprioception has no way to see it coming.
/// This instead queries `StaircaseCfg::height_at`/`snap_to_tread` at the
/// swing target's current world x every tick: raises the *z* component to
/// `terrain_height + clearance_m` (continuous ground-contouring rather than
/// a threshold-triggered correction), and, separately, nudges the *x*
/// component off a riser edge and onto solid tread by `horizontal_margin_m`.
///
/// `clearance_m` alone (`horizontal_margin_m = 0`) is what
/// `namiashi_staircase_5cm_terrain_footplan` measured: gets onto and
/// balances on the first tread for ~7 s, but stalls there -- touchdown x
/// oscillates right at the tread-1/riser boundary (1.44-1.56 m against a
/// riser at 1.5 m) rather than committing onto solid ground, which is
/// exactly what `horizontal_margin_m` targets.
#[derive(Clone, Copy, Debug)]
pub struct TerrainFootplanCfg {
    pub clearance_m: f64,
    pub horizontal_margin_m: f64,
}

/// Per-leg NOMINAL STANCE height, terrain-informed -- the support-side
/// counterpart to [`TerrainFootplanCfg`]'s swing-side touchdown height.
///
/// `auto_detect_kinematics_config` gives all four legs one shared
/// `nominal_foot_body` offset, and `run_wbc_sim` then shifts all four by the
/// same `trunk_drop_m`. That is a flat-ground assumption baked into the leg
/// geometry itself: on a staircase the front and rear legs are on different
/// steps for essentially the whole climb, so a single shared support height
/// asks the front legs to stand as far below the trunk as the rear ones
/// while the ground under them is 5-10 cm higher.
///
/// Distinct from the footplan in what it moves. The footplan retargets a
/// SWING foot's touchdown; this moves the stance geometry the whole gait is
/// built around -- `Footstep`'s lift-off/touch-down pair is centred on
/// `nominal_foot_body`, so raising one leg's nominal raises where that leg
/// stands, steps from, and returns to. Applied as a difference from the
/// four-leg mean rather than an absolute height, so the body's own standing
/// height is untouched (the mean offset is zero by construction) and only
/// the front-to-rear support pattern tilts to match the stairs. Reduces to
/// an exact no-op on flat ground, where every leg's terrain height is equal.
///
/// `GaitController::set_kinematics`'s own doc names `nominal_foot_body` as a
/// field that IS safe to change between calls (unlike joint names, which
/// would invalidate cached indices), so this is a supported runtime edit
/// rather than a reach around the controller.
#[derive(Clone, Copy, Debug)]
pub struct TerrainStanceCfg {
    /// Fraction of the measured terrain difference actually applied. 1.0
    /// levels the support pattern to the stairs exactly; lower values ask
    /// how much of the correction is needed, and 0.0 is a no-op.
    pub gain: f64,
    /// Clamp on the per-leg offset, metres, in case a leg's nominal x lands
    /// somewhere with a large height jump.
    pub max_offset_m: f64,
}

/// See `WbcParams::hip_bias_gate`'s doc comment.
#[derive(Clone, Copy, Debug)]
pub struct HipBiasGateCfg {
    /// Swing-leg FK tracking error, metres, above which the gate opens.
    pub trigger_m: f64,
    /// `hip_lr_bias_rad` magnitude applied while the gate is open, at the
    /// moment the gate opens (`err == trigger_m`).
    pub bias_mag: f64,
    /// Extra bias per metre of FK error beyond `trigger_m`, added to
    /// `bias_mag` at trigger time -- e.g. a bigger riser collision gets a
    /// bigger correction, rather than every trigger getting the same
    /// constant nudge regardless of how far off the nominal foothold the
    /// leg actually was. 0.0 recovers the original constant-magnitude
    /// gate. The magnitude is fixed for the whole `duration_s` window
    /// once computed at trigger time, not recomputed every tick, so a
    /// later smaller error mid-window can't shrink an already-open gate.
    pub bias_gain: f64,
    /// Hard clamp on the trigger-time magnitude (`bias_mag +
    /// bias_gain * (err - trigger_m)`), radians -- a safety bound so the
    /// gain term can't run away on a large collision.
    pub max_bias_rad: f64,
    /// How long the gate stays open after the last trigger, seconds.
    pub duration_s: f64,
}

pub struct WbcParams {
    pub total_time_s: f64,
    pub burn_in_s: f64,
    pub cmd_vx: f64,
    pub cmd_vy: f64,
    pub cmd_wz: f64,
    /// Model file under `tests/fixtures/namiashi/`.
    pub misa_file: &'static str,
    /// Early-touchdown force at which `ContactDrivenPhase` overrides the
    /// nominal phase, newtons. The harness has always used 5.0. Heavier legs
    /// hit harder, so on the 3.3 kg models this threshold fires on contacts
    /// the 2.4 kg model never produced.
    pub early_contact_n: f64,
    /// Diagnostic: drop the WBC's torque and the MPC's GRF reference, leaving
    /// only the joint position-PD tracking the IK targets. If the measured
    /// gait does not change, the dynamic layers are not contributing.
    pub kinematic_only: bool,
    /// Give the WBC the robot it is actually driving. `WbcPipeline::new`
    /// hardcodes `mass_kg: 9.0` and a 9 kg inertia diagonal; namiashi is
    /// 3.3 kg. Off by default so the effect can be measured against the
    /// state every earlier result in this file was produced under.
    pub wbc_real_inertia: bool,
    /// Decomposition of `wbc_real_inertia`, which bundles three changes:
    /// the mass (9.0 -> 3.3, a 2.7x amplification of `a_base_des`), the CoM
    /// offset, and the composite inertia (which also switches the pipeline
    /// onto the CoM-moment-arm accel prediction). Each can be applied alone.
    pub wbc_real_mass_only: bool,
    pub wbc_real_com_only: bool,
    pub wbc_real_inertia_only: bool,
    /// Minimum normal force on commanded-stance feet, as a fraction of the
    /// static per-foot share `m*g/4`. Expressed as a fraction rather than
    /// newtons so it means the same thing on the 2.4 and 3.3 kg models.
    pub f_min_stance_frac: f64,
    /// Override for `WbcWeights::base_accel` (default 200.0). This is the
    /// largest soft weight in the QP and the one that carries the MPC's
    /// predicted base acceleration into the torque.
    pub base_accel_weight: Option<f64>,
    /// Override for `WbcWeights::contact_force` (default 5.0) -- how hard the
    /// WBC pulls its own GRF solution toward the MPC's prediction.
    pub contact_force_weight: Option<f64>,
    /// `WbcPipeline::yaw_pd_gain`: an explicit `(kp, kd)` heading correction,
    /// additive on top of whatever the GRF-derived feedforward already does
    /// -- `(0.0, 0.0)` (the default everywhere else in this file) is an
    /// exact no-op. Nothing commands a turn on the staircase (cmd_wz stays
    /// 0 throughout), yet yaw drifts by a full 180 deg over ~5-8 s while
    /// the robot is balanced on a 3 cm-riser tread -- this is the direct
    /// lever to test whether that drift is simply unregulated rather than
    /// something a footplan or WBC weight change would ever reach.
    pub yaw_pd_gain: Option<(f64, f64)>,
    /// Constant hip-roll offset (IK convention, radians), added to the
    /// LEFT legs (FL, RL) and SUBTRACTED from the RIGHT legs (FR, RR),
    /// every tick, stance and swing alike -- a persistent left-right
    /// stance-width asymmetry, not a footstep-plan or swing-only
    /// correction. Taken directly from a namiashi RL policy's own
    /// recorded joint trace (go2_rl/namiashi_rl), which does NOT show
    /// this on flat ground (L-R hip asymmetry ~0.01 rad, noise level) but
    /// holds a consistent +0.07 to +0.16 rad asymmetry throughout all ten
    /// riser crossings of a successful 5cm climb -- this field tests
    /// whether that alone, injected into the existing WBC/IK output
    /// rather than learned, buys any of the same yaw/roll stability.
    /// `None` (everywhere else in this file) is a no-op.
    pub hip_lr_bias_rad: Option<f64>,
    /// A GATED version of `hip_lr_bias_rad`: instead of applying constantly,
    /// only activate (for `duration_s` seconds) once any swing leg's FK
    /// tracking error exceeds `trigger_m` -- the same collision signal
    /// `ContactReflexCfg` already uses, computed independently here so
    /// this field works without `contact_reflex` also being set. The
    /// point: a constant bias (`hip_lr_bias_rad` alone) did not help
    /// (`namiashi_staircase_5cm_rl_inspired_hip_bias`); this tests whether
    /// the RL policy's benefit instead came from applying that same
    /// correction only IN RESPONSE to a detected riser disturbance --
    /// i.e. an explicit, hand-written state-based rule standing in for
    /// whatever implicit state-conditioned behavior the RL policy learned.
    /// The three fields are exactly what a small gradient-free search
    /// (see `namiashi_staircase_5cm_hip_gate_search`) optimizes.
    pub hip_bias_gate: Option<HipBiasGateCfg>,
    /// Write the exact MJCF the sim runs plus a per-tick root-pose and joint
    /// trace here, for `render_namiashi.py` to replay. Purely a side channel;
    /// nothing in the harness reads it back.
    pub replay_dir: Option<String>,
    /// Lower the nominal stance by this much, metres. Applied to every leg's
    /// `nominal_foot_body.z`, which is what both the IK seed and the MPC's
    /// body-z reference are taken from, so the whole stack follows.
    /// Defaults to [`NAMIASHI_STANCE_DROP_M`].
    pub trunk_drop_m: f64,
    /// Constant offset added to the base position the WBC observes, and a
    /// per-second drift on top of it. Both are diagnostics for the hardware
    /// question: is a bounded absolute position actually required?
    pub base_pos_bias_m: [f64; 3],
    pub base_pos_drift_mps: [f64; 3],
    /// How the observed body velocity is corrupted before the controller sees
    /// it. The hardware question: with only an IMU there is no bounded
    /// velocity estimate to be had -- 1 deg of attitude error leaks
    /// g*sin(1 deg) = 0.17 m/s^2 of phantom horizontal acceleration, which is
    /// 0.85 m/s of velocity error in five seconds against a 0.80 m/s command.
    /// So: how much does this controller actually depend on it?
    pub vel_obs: VelObs,
    /// Which gait controller to run. `Mpc` is the body-root SRBD path this
    /// file has always used; `FullCentroidal` is the one that carries the
    /// OCS2-derived predicted-footstep planner.
    pub gait_mode: GaitMode,
    /// Enable `set_use_mpc_predicted_footstep` -- the legged_control /
    /// OCS2 `SwingTrajectoryPlanner` analogue, which takes the foothold
    /// correction from the MPC's own predicted base displacement over one
    /// swing instead of extrapolating `k_capture * v_err`. Only has an
    /// effect under `GaitMode::FullCentroidal`.
    pub mpc_predicted_footstep: bool,
    /// FullCentroidal's `legged_control_parity`: builds the per-step contact
    /// schedule from a per-leg phase projection and enables the OCS2-shaped
    /// swing reference. Prerequisite for `dynamic_joint_q_reference`.
    pub legged_control_parity: bool,
    /// Sample the swing/stance foot curve at each horizon step's projected
    /// phase for the MPC's joint_q reference, instead of holding it flat.
    ///
    /// Note this changes what the MPC *plans against*, not what the joints
    /// are commanded to. `FullCentroidalMpcGaitController`'s own docs are
    /// explicit that the output joint angles remain the analytical IK's --
    /// the MPC's joint_q exists so the per-node moment arm
    /// `r = R (foot_body(q) - com_offset)` updates within the horizon. There
    /// is no equivalent of legged_control's
    /// `pos_des = getJointAngles(optimized_state)` in this implementation.
    pub dynamic_joint_q_reference: bool,
    /// Input cost on the 24-state MPC's GRF entries, `r_diag[0..12]`.
    ///
    /// The default is `[1e-3; 24]` -- one scalar across both halves of an
    /// input vector whose first twelve entries are forces in newtons and
    /// whose last twelve are joint velocities in rad/s. The field's own doc
    /// says those "two distinct scales coexist ... unlike the 12-state
    /// version we cannot share a scalar", and then the default shares one.
    /// `q_diag` is `[1.0; 24]` over a state mixing radians, metres, m/s and
    /// joint angles, with the same problem.
    ///
    /// `None` leaves the default. The 12-state SRBD does not suffer this
    /// because its twelve inputs are all forces.
    /// SRBD horizon length in steps. The default 10 at `dt_per_step = 0.030`
    /// is 0.300 s -- shorter than Trot's 0.320 s cycle, so the MPC cannot see
    /// one complete contact sequence. `legged_control` uses 1.0 s over 67
    /// nodes, roughly two cycles of its own gait.
    pub mpc_horizon_steps: Option<usize>,
    /// Fore-aft position cost, `q_diag[p_x]`. Zero in all three MPCs here;
    /// `task.info:159` gives it 1000. Without it the MPC has no objective that
    /// grows when the body falls behind, which is why it plans +0.22 N.
    pub mpc_px_cost: Option<f64>,
    /// `set_task_space_joint_vel_weight` -- `legged_control`'s
    /// `initializeInputCostWeight` maps a task-space foot-velocity weight
    /// through the leg Jacobian into joint space. Implemented here and never
    /// called, so the joint-velocity cost is isotropic in rad/s instead.
    pub fcm_taskspace_jv_weight: Option<[f64; 3]>,
    /// Warm start with one SQP iteration, as the reference does, instead of
    /// three cold ones.
    pub fcm_warm_start: bool,
    /// FullCentroidal horizon, in steps and seconds-per-step. The default is
    /// 10 x 0.030 = 0.300 s against legged_control's 1.0 s, and
    /// `set_srbd_mpc_config` cannot reach it -- that setter is a silent no-op
    /// outside `GaitMode::Mpc`, so `mpc_horizon_steps` does nothing here.
    pub fcm_horizon_steps: Option<usize>,
    pub fcm_dt_per_step: Option<f64>,
    /// SQP iterations, separately from `fcm_warm_start`. The warm-start path
    /// also drops iterations from 3 to 1, and those are two different changes.
    pub fcm_sqp_iterations: Option<usize>,
    /// Solve the FullCentroidal QP in sparse multiple-shooting form. See
    /// `FullCentroidalMpcConfig::sparse_qp` -- the condensed form forms
    /// `A_d^k` explicitly and dies at any horizon worth having.
    pub fcm_sparse_qp: bool,
    pub fcm_grf_cost: Option<f64>,
    /// `r_diag[12..24]` -- the joint-velocity cost. `fcm_grf_cost` only sets
    /// the GRF half, and the default leaves this at 1.0 against the GRF's
    /// 1e-3, so ground force is a thousand times cheaper than leg motion.
    pub fcm_jointv_cost: Option<f64>,
    /// Ablation of the `base_accel` task's feedforward. When set, the GRF fed
    /// into `WbcPipeline::solve` (both the linear/angular Newton's-law
    /// feedforward and the priority-2 contact_force reference) is replaced by
    /// a quasi-static gravity split across whichever feet are in stance --
    /// no momentum plan, no footstep-driven moment -- and the pipeline's
    /// `roll_pd_gain`/`pitch_pd_gain` are set to this `(kp, kd)`, so attitude
    /// correction comes entirely from an explicit PD term rather than from
    /// whatever GaitMode is doing upstream. Isolates what the MPC's own
    /// predicted trajectory is contributing through the channel
    /// (`base_accel`, priority 1) that already has real authority, as
    /// opposed to a bare regulator.
    pub attitude_pd_ablation: Option<(f64, f64)>,
    /// Replace the flat ground plane with a staircase. `None` (default)
    /// behaves exactly as before -- the infinite `GroundPlaneCfg` plane.
    pub staircase: Option<StaircaseCfg>,
    /// Proprioceptive "hit something mid-swing" recovery. `None` (default)
    /// leaves every swing leg tracking its open-loop target unmodified, no
    /// matter how far off it drifts -- the behaviour every other test in
    /// this file assumes.
    pub contact_reflex: Option<ContactReflexCfg>,
    /// Perception-informed swing height, using `StaircaseCfg::height_at` as
    /// an idealized stand-in for a real height-map. `None` (default) is the
    /// terrain-blind behaviour every other test in this file assumes.
    pub terrain_footplan: Option<TerrainFootplanCfg>,
    /// See [`TerrainStanceCfg`]. `None` leaves all four legs sharing one
    /// nominal stance height, which is what every other test here uses.
    pub terrain_stance: Option<TerrainStanceCfg>,
    /// See [`ProprioStanceCfg`] -- the same body levelling, with the terrain
    /// oracle replaced by IMU + encoders. Mutually exclusive with
    /// `terrain_stance` in practice; both write the same nominal.
    pub proprio_stance: Option<ProprioStanceCfg>,
    /// Run on the かわさきロボット競技大会 ring instead of flat ground or a
    /// staircase. Mutually exclusive with `staircase`; the ring brings its
    /// own plate, so no separate ground plane is emitted either.
    pub kawasaki_ring: Option<crate::ring::KawasakiRingCfg>,
    /// A second, joint-locked robot dropped into the scene as the opponent:
    /// `(pose, world position)`. It has the real robot's masses, inertias
    /// and collision shapes -- tipping something over is entirely a question
    /// of where its mass is -- but no actuators and no hinges, so it cannot
    /// act. Its root free joint stays, because it does have to fall over.
    pub opponent: Option<(crate::ring::LockedPose, [f64; 3])>,
    /// Timings and amplitudes of the `X` attack.
    pub attack_params: crate::attack::AttackParams,
    /// Where to put the robot's base at t=0, `(x, y)`. `None` spawns at the
    /// origin, which is the approach floor on a staircase but the centre
    /// obstacle on the ring.
    pub spawn_xy: Option<(f64, f64)>,
    /// Per-block state cost for the 24-state MPC: `[v_com, omega, base_pos,
    /// euler, joint_q]`, applied over `q_diag`'s
    /// `[0..3, 3..6, 6..9, 9..12, 12..24]`.
    ///
    /// The default is `[1.0; 24]` over five different physical quantities --
    /// m/s, rad/s, m, rad, rad. The base position entry is the one to look at
    /// first: it grows without bound as the robot walks, so a weight on it is
    /// a weight on an error that can only increase.
    pub fcm_state_cost: Option<[f64; 5]>,
    /// Add the missing `- omega_b x v_b` term to the WBC's base-accel
    /// reference. See `WbcPipeline::base_accel_coriolis`.
    pub base_accel_coriolis: bool,
    /// Set every `WbcWeights` entry to 1.0, as `legged_control` effectively
    /// has them -- it concatenates tasks within a priority level unweighted.
    pub flat_wbc_weights: bool,
    /// Drop the `tau_gravity` task, which `legged_control` does not have.
    pub drop_tau_gravity: bool,
    /// Give the SRBD MPC namiashi's composite inertia instead of the heaviest
    /// link's.
    ///
    /// `auto_detect_srbd_mpc_config` takes the heaviest link's own tensor,
    /// which on this model is the 0.872 kg trunk: (0.00111, 0.00504, 0.00529)
    /// against a composite of (0.02722, 0.07575, 0.06584), so 12 to 24 times
    /// too small. A pitch inertia that small tells the MPC a tiny moment buys
    /// a large angular acceleration.
    ///
    /// Fixing it inside `auto_detect` was tried and reverted: it costs Go2
    /// 0.485 -> 0.194 m/s at a 1.00 m/s command, and Go2's tuning was built
    /// against the old value. The function's doc says to set it per robot
    /// instead, which is what this does.
    pub mpc_composite_inertia: bool,
    /// Which actuator interface the controller drives.
    pub actuation: Actuation,
    /// Rate at which the whole host-side controller runs -- gait generator,
    /// WBC, and the command it emits. `None` means every physics tick, which
    /// is what this file has always assumed and no robot on a shared CAN bus
    /// gets. Between updates the last command is held.
    ///
    /// Only rates that divide the physics rate are representable, because the
    /// gate is an integer tick count. At the default `dt` of 0.002 s that is
    /// 500 / 250 / 167 / 125 / 100 Hz and nothing between -- asking for 400
    /// silently gives 500, and asking for 200 silently gives 167. The run
    /// prints what it actually used; set a finer `dt` to reach other rates.
    pub host_rate_hz: Option<f64>,
    /// Piecewise-constant command schedule: `(t_from, vx, vy, wz)`. Overrides
    /// `cmd_vx/vy/wz` once the first entry's time is reached. For asking how
    /// the two interfaces handle a command that moves, rather than one held
    /// constant for the whole run.
    pub cmd_schedule: Vec<(f64, f64, f64, f64)>,
    /// Live teleop state (velocity command + requested gait), updated
    /// asynchronously by the viewer's keyboard callback and read every
    /// physics tick. The command takes priority over `cmd_vx/vy/wz` and
    /// `cmd_schedule` once burn-in ends; a changed gait is applied by
    /// swapping the whole `GaitConfig` (see `namiashi_tuned_gait_config`).
    /// `None` (the default) leaves every other call site's fixed- or
    /// scheduled-command behavior completely unaffected.
    #[cfg(feature = "mujoco-viewer")]
    pub live_teleop: Option<std::sync::Arc<std::sync::Mutex<crate::teleop::LiveTeleop>>>,
    /// Render rate for `live_viewer`, Hz. `None` = 60.
    ///
    /// Worth lowering when the display is the bottleneck rather than the
    /// physics -- over `ssh -X`, for instance, where every frame is shipped
    /// as X protocol and costs hundreds of milliseconds regardless of what
    /// is in it. The loop advances `render_decim` physics ticks per frame,
    /// so a slow frame caps how much simulated time passes: at 60 Hz a
    /// 400 ms frame yields 16.6 ms of sim (rt 0.04), while at 5 Hz the same
    /// frame yields 200 ms (rt 0.5). Choppier, but the robot moves at
    /// something like real speed and stays steerable.
    pub render_hz: Option<f64>,
    /// Open a real-time `mujoco::viewer::MjViewer` (feature `mujoco-viewer`)
    /// on the sim instead of running headless-and-tracing. Runs until the
    /// viewer window is closed rather than for a fixed `total_time_s`.
    pub live_viewer: bool,
    /// World-frame push on the trunk: `(t_start, [fx, fy, fz], duration)`.
    /// A disturbance neither interface plans for, so it is the one test that
    /// asks what happens when the model is wrong.
    pub push: Option<(f64, [f64; 3], f64)>,
    pub dt: f64,
    /// `None` = the legacy `wbc::solve_warm_with_weights` path
    /// (walk-validated default). `Some` opts the pipeline into the
    /// misa-wbc `Dynamics`-backed [`WbcSolver`] with the given
    /// formulation/strategy/backend — the equivalence-study switch
    /// documented in `ref/wbc_comparison.md`.
    pub misa_wbc_mode: Option<(wbc::Formulation, wbc::SolveConfig)>,
    /// Gait family. `None` keeps `GaitConfig::trot()`, which is what the
    /// original four tests ran and the only thing this file had ever
    /// exercised.
    pub gait_type: Option<GaitType>,
    /// Overrides applied after the family's own defaults. namiashi is 2.400 kg
    /// against Go2's 15.606 with a 0.306 m leg against 0.426, so the numbers
    /// tuned on Go2 do not carry over directly -- under Froude similarity
    /// (T proportional to sqrt(L/g), stride to L) Go2's 0.18 s / 0.20 m
    /// become 0.152 s / 0.143 m here. `None` keeps the family default.
    pub cycle_period_s: Option<f64>,
    pub duty_factor: Option<f64>,
    pub max_step_length_m: Option<f64>,
    /// Swing-foot apex clearance. Crawl's library default is 0.005 m, which
    /// is fine over a 0.06 m step and almost certainly scuffing over a
    /// 0.145 m one.
    pub swing_height_m: Option<f64>,
    /// Capture-point feedback gain, seconds. The library default is 0.05 s
    /// for every robot; the LIP value it is meant to approximate is
    /// sqrt(h/g), which for namiashi's 0.30 m trunk is 0.175 s.
    pub k_capture_s: Option<f64>,
}

impl WbcParams {
    pub fn static_stand() -> Self {
        Self {
            total_time_s: 1.5,
            burn_in_s: 0.5,
            cmd_vx: 0.0,
            dt: 0.002,
            misa_wbc_mode: None,
            gait_type: None, cycle_period_s: None,
            duty_factor: None, max_step_length_m: None,
            swing_height_m: None, k_capture_s: None,
            cmd_vy: 0.0, cmd_wz: 0.0,
            misa_file: DEFAULT_MISA,
            early_contact_n: 5.0,
            kinematic_only: false,
            wbc_real_inertia: false,
            wbc_real_mass_only: false,
            wbc_real_com_only: false,
            wbc_real_inertia_only: false,
            f_min_stance_frac: 0.0,
            base_accel_weight: None,
            contact_force_weight: None,
            yaw_pd_gain: None,
            hip_lr_bias_rad: None,
            hip_bias_gate: None,
            replay_dir: None,
            trunk_drop_m: NAMIASHI_STANCE_DROP_M,
            base_pos_bias_m: [0.0; 3],
            base_pos_drift_mps: [0.0; 3],
            vel_obs: VelObs::Truth,
            gait_mode: GaitMode::Mpc,
            mpc_predicted_footstep: false,
            legged_control_parity: false,
            dynamic_joint_q_reference: false,
            mpc_horizon_steps: None,
            mpc_px_cost: None,
            fcm_taskspace_jv_weight: None,
            fcm_warm_start: false,
            fcm_horizon_steps: None,
            fcm_dt_per_step: None,
            fcm_sqp_iterations: None,
            fcm_sparse_qp: false,
            fcm_grf_cost: None,
            fcm_jointv_cost: None,
            attitude_pd_ablation: None,
            staircase: None,
            contact_reflex: None,
            terrain_footplan: None,
            terrain_stance: None,
            proprio_stance: None,
            kawasaki_ring: None,
            opponent: None,
            attack_params: crate::attack::AttackParams::DEFAULT,
            spawn_xy: None,
            render_hz: None,
            fcm_state_cost: None,
            base_accel_coriolis: false,
            flat_wbc_weights: false,
            drop_tau_gravity: false,
            mpc_composite_inertia: false,
            actuation: Actuation::PositionTorque,
            host_rate_hz: None,
            cmd_schedule: Vec::new(),
            #[cfg(feature = "mujoco-viewer")]
            live_teleop: None,
            live_viewer: false,
            push: None,
        }
    }
    pub fn forward_walk() -> Self {
        Self {
            attack_params: crate::attack::AttackParams::DEFAULT,
            total_time_s: 3.0,
            burn_in_s: 0.5,
            cmd_vx: 0.15,
            dt: 0.002,
            misa_wbc_mode: None,
            gait_type: None, cycle_period_s: None,
            duty_factor: None, max_step_length_m: None,
            swing_height_m: None, k_capture_s: None,
            cmd_vy: 0.0, cmd_wz: 0.0,
            misa_file: DEFAULT_MISA,
            early_contact_n: 5.0,
            kinematic_only: false,
            wbc_real_inertia: false,
            wbc_real_mass_only: false,
            wbc_real_com_only: false,
            wbc_real_inertia_only: false,
            f_min_stance_frac: 0.0,
            base_accel_weight: None,
            contact_force_weight: None,
            yaw_pd_gain: None,
            hip_lr_bias_rad: None,
            hip_bias_gate: None,
            replay_dir: None,
            trunk_drop_m: NAMIASHI_STANCE_DROP_M,
            base_pos_bias_m: [0.0; 3],
            base_pos_drift_mps: [0.0; 3],
            vel_obs: VelObs::Truth,
            gait_mode: GaitMode::Mpc,
            mpc_predicted_footstep: false,
            legged_control_parity: false,
            dynamic_joint_q_reference: false,
            mpc_horizon_steps: None,
            mpc_px_cost: None,
            fcm_taskspace_jv_weight: None,
            fcm_warm_start: false,
            fcm_horizon_steps: None,
            fcm_dt_per_step: None,
            fcm_sqp_iterations: None,
            fcm_sparse_qp: false,
            fcm_grf_cost: None,
            fcm_jointv_cost: None,
            attitude_pd_ablation: None,
            staircase: None,
            contact_reflex: None,
            terrain_footplan: None,
            terrain_stance: None,
            proprio_stance: None,
            kawasaki_ring: None,
            opponent: None,
            spawn_xy: None,
            render_hz: None,
            fcm_state_cost: None,
            base_accel_coriolis: false,
            flat_wbc_weights: false,
            drop_tau_gravity: false,
            mpc_composite_inertia: false,
            actuation: Actuation::PositionTorque,
            host_rate_hz: None,
            cmd_schedule: Vec::new(),
            #[cfg(feature = "mujoco-viewer")]
            live_teleop: None,
            live_viewer: false,
            push: None,
        }
    }

    /// Same schedule as [`Self::static_stand`], routed through
    /// `WbcSolver` with the given formulation/strategy/backend.
    pub fn static_stand_misa_wbc(formulation: wbc::Formulation, cfg: wbc::SolveConfig) -> Self {
        Self { misa_wbc_mode: Some((formulation, cfg)), ..Self::static_stand() }
    }

    /// Same schedule as [`Self::forward_walk`], routed through
    /// `WbcSolver` with the given formulation/strategy/backend.
    pub fn forward_walk_misa_wbc(formulation: wbc::Formulation, cfg: wbc::SolveConfig) -> Self {
        Self { misa_wbc_mode: Some((formulation, cfg)), ..Self::forward_walk() }
    }
}

/// The settings each gait was tuned to, and the numbers they have to hold.
///
/// `k_capture = 0.0` is not an oversight -- see `namiashi_tuned_gaits_hold`.
pub const NAMIASHI_TUNED: [(GaitType, f64, f64, f64, f64, f64); 3] = [
    // gait, cycle_period_s, duty, max_step_m, swing_height_m, cmd_vx
    //
    // Retuned for the corrected 3.3 kg mass. Two rows moved:
    //   Trot 0.260 -> 0.320 s. At 0.260 the corrected model was airborne
    //     2.0-2.8% of the time with 4.5 deg of roll; 0.320 cuts that to
    //     0.5-1.3%. The 2.4 kg model was never airborne at either.
    //   Walk 0.400 -> 0.500 s, command 0.380 -> 0.330. T=0.400 has a failure
    //     band from ~0.37 to ~0.43 m/s that only exists with mass out at the
    //     thigh and calf; T=0.500 has none. Its ceiling is
    //     0.145/(0.500*0.75) = 0.387, so 0.330 keeps 15% of margin.
    // Crawl was 101-102% at every speed tried on every model and is unchanged.
    (GaitType::Trot, 0.320, 0.50, 0.145, 0.040, 0.800),
    (GaitType::Walk, 0.500, 0.75, 0.145, 0.035, 0.330),
    (GaitType::Crawl, 0.800, 0.85, 0.145, 0.040, 0.170),
];

pub fn namiashi_tuned_params(i: usize) -> WbcParams {
    let (gait, t, duty, step, h, cmd_vx) = NAMIASHI_TUNED[i];
    WbcParams {
        total_time_s: 26.0,
        burn_in_s: 1.0,
        cmd_vx,
        gait_type: Some(gait),
        cycle_period_s: Some(t),
        duty_factor: Some(duty),
        max_step_length_m: Some(step),
        swing_height_m: Some(h),
        k_capture_s: Some(NAMIASHI_CAPTURE_GAIN_S),
        ..WbcParams::forward_walk()
    }
}

/// That gait's own row in [`NAMIASHI_TUNED`], or Trot's if it has none
/// (only Trot/Walk/Crawl were ever tuned for namiashi).
fn namiashi_tuned_row(gait: GaitType) -> (GaitType, f64, f64, f64, f64, f64) {
    NAMIASHI_TUNED
        .iter()
        .copied()
        .find(|row| row.0 == gait)
        .unwrap_or(NAMIASHI_TUNED[0])
}

/// The forward speed [`NAMIASHI_TUNED`] settled on for this gait. Each is
/// bounded by its own `max_step_length_m / (cycle_period_s * duty_factor)`,
/// so they are genuinely different numbers, not one speed with different
/// leg timings -- see [`crate::teleop::SpeedEnvelope::for_gait`].
pub fn namiashi_tuned_cmd_vx(gait: GaitType) -> f64 {
    namiashi_tuned_row(gait).5
}

/// The peak swing-foot lift [`NAMIASHI_TUNED`] settled on for this gait.
pub fn namiashi_tuned_swing_height_m(gait: GaitType) -> f64 {
    namiashi_tuned_row(gait).4
}

/// A [`GaitConfig`] carrying this gait's tuned period/duty/step/swing.
/// Used to swap gaits at runtime (`GaitController::set_config`) in the
/// interactive teleop demo, so a live switch lands on exactly the same
/// settings a batch run of that gait would have used.
pub fn namiashi_tuned_gait_config(gait: GaitType) -> GaitConfig {
    let (_, t, duty, step, h, _) = namiashi_tuned_row(gait);
    let mut cfg = match gait {
        GaitType::Walk => GaitConfig::walk(),
        GaitType::Pace => GaitConfig::pace(),
        GaitType::Bound => GaitConfig::bound(),
        GaitType::Crawl => GaitConfig::crawl(),
        GaitType::Trot => GaitConfig::trot(),
    };
    cfg.cycle_period_s = t;
    cfg.duty_factor = duty;
    cfg.max_step_length_m = step;
    cfg.swing_height_m = h;
    cfg
}

/// Per-leg stance height from PROPRIOCEPTION ONLY -- the deployable
/// counterpart to [`TerrainStanceCfg`].
///
/// `TerrainStanceCfg` levels the body by asking `StaircaseCfg::height_at`
/// how high the ground under each leg is. That is an oracle: exact,
/// noise-free, occlusion-free advance knowledge of the terrain, i.e. a
/// stand-in for a vision system. namiashi has no room for one, so this
/// derives the same per-leg heights from what the robot actually carries:
/// joint encoders and an IMU.
///
/// # How a leg's ground height is known without seeing it
///
/// A foot that is IN CONTACT is standing on the ground, so its own position
/// tells you where the ground is. Forward kinematics from the encoders gives
/// that foot in the body frame; rotating by the IMU's attitude estimate puts
/// it in a gravity-aligned frame, where its z is the foot's height below the
/// body measured against gravity rather than against the (possibly tilted)
/// chassis. Do that for every foot in contact and the spread of those
/// heights IS the local relief -- measured, not predicted.
///
/// Yaw does not enter: rotating a vector by yaw leaves its z alone, so the
/// estimate is immune to the heading drift an IMU without a magnetometer
/// always has. Only roll and pitch matter, and those are exactly what an
/// accelerometer observes.
///
/// # What it cannot do
///
/// It only knows terrain a foot has ALREADY touched. A vision system sees
/// the step before the leg arrives; this sees it on landing. For the case
/// this was asked for -- standing with some feet on a raised obstacle and
/// some on the flat ring -- that is enough, because the feet are already
/// there. For striding onto something new it is one step behind, and the
/// first footfall onto a new level still lands unlevelled.
#[derive(Clone, Copy, Debug)]
pub struct ProprioStanceCfg {
    /// Fraction of the measured height difference applied. 1.0 levels the
    /// support pattern to what the feet report; 0.0 is a no-op.
    pub gain: f64,
    /// Clamp on the per-leg offset, metres.
    pub max_offset_m: f64,
    /// Time constant of the per-leg height filter, seconds. The raw estimate
    /// moves with every contact transition and with each leg's own swing
    /// arc, so it is smoothed before it is allowed to move the stance the
    /// whole gait is built on.
    pub tau_s: f64,
    /// Normal force above which a foot counts as in contact, N. Comes from a
    /// foot force sensor on hardware, or from the joint-torque residual --
    /// either way proprioceptive. Deliberately NOT the gait schedule's own
    /// `is_stance`: the schedule says when a foot is *supposed* to be down,
    /// and uneven ground is precisely where that is wrong.
    pub contact_n: f64,
    /// Madgwick filter gain (rad/s) for the IMU attitude used to project the
    /// feet into a gravity-aligned frame.
    pub imu_beta: f64,
}

impl Default for ProprioStanceCfg {
    fn default() -> Self {
        Self { gain: 1.0, max_offset_m: 0.10, tau_s: 0.20, contact_n: 3.0, imu_beta: 0.10 }
    }
}

/// Run a WBC sim, sampling per-tick. Returns `None` if the namiashi
/// fixture is missing (skip cleanly).
pub fn run_wbc_sim(params: WbcParams) -> Option<Vec<WbcSample>> {
    let path = namiashi_misa_named(params.misa_file);
    if !path.exists() {
        eprintln!(
            "namiashi fixture missing at {} — skipping WBC test",
            path.display()
        );
        return None;
    }
    // Load from the master .misa so PD gains (kp=100, kv=1.2) and
    // joint damping (0.1) come from the same source the GUI uses; the
    // burn-in Position-PD then settles at the real GUI body-z. See
    // commit `f53482c` for the same migration in gait_walk_stability.
    let mut robot = RobotModel::from_misa(&path).expect("load namiashi .misa");

    let mut kin = auto_detect_kinematics_config(&robot, &DEFAULT_FOOT_LINKS)
        .expect("auto-detect kinematics");
    for leg_kin in [&mut kin.fl, &mut kin.fr, &mut kin.rl, &mut kin.rr] {
        let total_leg = leg_kin.upper_leg_m + leg_kin.lower_leg_m;
        leg_kin.nominal_foot_body.z += 0.08 * total_leg;
        // Positive z moves the nominal foot toward the body, i.e. crouches.
        leg_kin.nominal_foot_body.z += params.trunk_drop_m;
    }
    seed_joint_positions_from_kinematics(&mut robot, &kin);

    // Actuator interface. Set before the sim is built so the exported MJCF
    // and the per-tick control law agree.
    if !matches!(params.actuation, Actuation::PositionTorque) {
        // Resolve the twelve leg joints by name -- the gait controller, which
        // would hand over the indices, is not built until after the sim.
        let leg_joint_names: Vec<String> = [&kin.fl, &kin.fr, &kin.rl, &kin.rr]
            .iter()
            .flat_map(|lk| {
                [
                    lk.hip_joint.clone(),
                    lk.thigh_joint.clone(),
                    lk.calf_joint.clone(),
                ]
            })
            .collect();
        for name in &leg_joint_names {
            let Some(&ji) = robot.joint_map.get(name.as_str()) else {
                panic!("velocity path: joint {name:?} not in the model");
            };
            match params.actuation {
                Actuation::Velocity { loop_kv, .. } => {
                    robot.joints[ji].actuator_mode = ActuatorMode::Velocity;
                    robot.joints[ji].actuator_kv = loop_kv;
                }
                Actuation::VelocityIdeal { .. } => {
                    robot.joints[ji].actuator_mode = ActuatorMode::Velocity;
                }
                Actuation::Torque { .. }
                | Actuation::TorqueLeggedControl { .. }
                | Actuation::LeggedControl { .. } => {
                    robot.joints[ji].actuator_mode = ActuatorMode::Torque;
                }
                Actuation::PositionTorque => unreachable!(),
            }
        }
    }

    // The ring and the staircase each bring their own floor, so the flat
    // plane is only emitted when neither is present.
    let ring = params.kawasaki_ring.clone();
    let opts = MjcfExportOptions {
        ground_plane: if params.staircase.is_none() && ring.is_none() {
            Some(GroundPlaneCfg { z: 0.0, half_size: 4.0, roll: 0.0, pitch: 0.0 })
        } else {
            None
        },
        extra_worldbody_xml: {
            let terrain = match (&ring, params.staircase) {
                (Some(r), _) => Some(r.worldbody_xml(RING_HFIELD)),
                (None, Some(s)) => Some(s.worldbody_xml()),
                (None, None) => None,
            };
            match params.opponent {
                None => terrain,
                Some((pose, at)) => Some(format!(
                    "{}\n{}",
                    terrain.unwrap_or_default(),
                    crate::ring::locked_robot_worldbody_xml(&robot, OPPONENT_PREFIX, at, pose),
                )),
            }
        },
        extra_asset_xml: ring.as_ref().map(|r| {
            let mut a = r.asset_xml(RING_HFIELD);
            if r.lighting {
                a += &articara::mjcf::scene_lighting_asset_xml();
            }
            a
        }),
        extra_visual_xml: ring
            .as_ref()
            .filter(|r| r.lighting)
            .map(|_| articara::mjcf::scene_lighting_visual_xml()),
        base_xy: params.spawn_xy,
        add_actuators: true,
        ..Default::default()
    };
    // Optional replay export for video rendering. Writes the exact MJCF the
    // sim is running plus a per-tick root-pose + joint trace, so a renderer
    // can replay the run kinematically without re-deriving any of it. Purely
    // a side channel -- nothing below reads it.
    let replay_out = params.replay_dir.clone();
    if let Some(dir) = replay_out.as_deref() {
        std::fs::create_dir_all(dir).expect("create replay dir");
        std::fs::write(
            format!("{dir}/model.xml"),
            articara::mjcf::export_mjcf_with_options(&robot, opts.clone()),
        )
        .expect("write replay model.xml");
    }
    let mut sim = MujocoSim::new(&robot, opts).expect("MujocoSim::new");
    if let Some(r) = &ring {
        // The <hfield> was declared with nrow/ncol and no file, so MuJoCo is
        // holding an uninitialised grid until this lands -- an unfilled one
        // is a perfectly flat ring, which would look like the obstacles
        // silently not existing rather than like an error.
        sim.set_hfield_data(RING_HFIELD, &r.heights())
            .expect("fill kawasaki ring hfield");
    }
    match params.actuation {
        Actuation::Velocity { loop_ki, .. } => sim.velocity_loop_ki = loop_ki,
        Actuation::VelocityIdeal { .. } => sim.velocity_loop_ideal = true,
        _ => {}
    }
    // We don't want gravity-comp to compete with the WBC during the
    // walking window — the WBC's floating-base EoM task already
    // handles it. But during burn-in (gait disabled, WBC inactive),
    // grav-comp keeps the body from sagging. Toggle is per-sim, so
    // we leave it on; the WBC bypasses the per-joint path entirely
    // when active.
    sim.set_gravity_compensation(true);

    let mut cfg = match params.gait_type {
        Some(GaitType::Trot) | None => GaitConfig::trot(),
        Some(GaitType::Walk) => GaitConfig::walk(),
        Some(GaitType::Pace) => GaitConfig::pace(),
        Some(GaitType::Bound) => GaitConfig::bound(),
        Some(GaitType::Crawl) => GaitConfig::crawl(),
    };
    if let Some(v) = params.cycle_period_s {
        cfg.cycle_period_s = v;
    }
    if let Some(v) = params.duty_factor {
        cfg.duty_factor = v;
    }
    if let Some(v) = params.swing_height_m {
        cfg.swing_height_m = v;
    }
    if let Some(v) = params.max_step_length_m {
        cfg.max_step_length_m = v;
    }
    if let Some(hz) = params.host_rate_hz {
        let decim = ((1.0 / hz) / params.dt).round().max(1.0);
        eprintln!(
            "[host] requested {hz:.0} Hz -> decim {decim:.0} -> effective \
             {:.1} Hz (physics {:.0} Hz)",
            1.0 / (params.dt * decim),
            1.0 / params.dt,
        );
    }
    eprintln!(
        "[gait] {:?}  T={:.3}s duty={:.3} max_step={:.3}m  cmd_vx={:.3}  \
         model={} m={:.3}kg",
        cfg.gait_type, cfg.cycle_period_s, cfg.duty_factor,
        cfg.max_step_length_m, params.cmd_vx,
        params.misa_file,
        robot.links.iter().map(|l| l.inertial.mass).sum::<f64>(),
    );
    // `mut` only because live teleop can swap the gait mid-run; every
    // non-interactive caller leaves both of these at their built values.
    #[allow(unused_mut)]
    let mut cycle_period_s = cfg.cycle_period_s;
    #[cfg(feature = "mujoco-viewer")]
    let mut live_gait = cfg.gait_type;
    #[cfg(feature = "mujoco-viewer")]
    let mut live_swing_height_m = cfg.swing_height_m;
    // Flat-ground baseline for `TerrainStanceCfg`: the shared nominal the
    // four legs were built with, before any per-leg terrain offset. Captured
    // rather than recomputed so the offset is always measured from one fixed
    // reference and cannot integrate drift across ticks.
    // Proprioceptive attitude: an actual IMU filter fed from the trunk IMU,
    // not `body_world_orientation`. The rest of this harness reads the sim's
    // ground-truth pose in places; the levelling below must not, or it would
    // be answering a question the robot cannot ask on hardware.
    let mut ahrs = articara::attitude_estimator::MadgwickAhrs::new(
        params.proprio_stance.map(|c| c.imu_beta).unwrap_or(0.1),
    );
    // Per-leg ground height in the gravity-aligned frame, filtered, plus
    // whether each has ever been seeded. A leg that has not touched down yet
    // has no estimate and must not contribute one.
    let mut leg_h_filt = [0.0_f64; 4];
    let mut leg_h_seen = [false; 4];
    // Last tick's measured per-foot normal force. Read at the TOP of a tick,
    // written at the bottom -- a controller acts on the force it has already
    // measured, not on one from a step it has not taken yet.
    let mut foot_fz_now = [0.0_f64; 4];

    // The arm is not part of the gait: the .misa drives it as its own
    // Position-mode actuator, and run_wbc_sim's Torque switch only touches
    // the twelve leg joints. So it is commanded by position target, and its
    // travel comes from the model's own limits rather than a guess.
    let arm_ji = robot.joint_map.get("arm_pitch_joint").copied();
    let arm_range = arm_ji.map(|ji| (robot.joints[ji].lower, robot.joints[ji].upper));
    let mut arm_angle = arm_ji.map(|ji| robot.joint_positions[ji]).unwrap_or(0.0);

    let base_nominal_z: [f64; 4] = [
        kin.fl.nominal_foot_body.z,
        kin.fr.nominal_foot_body.z,
        kin.rl.nominal_foot_body.z,
        kin.rr.nominal_foot_body.z,
    ];
    let mut gc = GaitController::build(&robot, kin.clone(), cfg, params.gait_mode)
        .expect("GaitController::build");
    if params.mpc_predicted_footstep {
        gc.set_use_mpc_predicted_footstep(true);
    }
    if params.mpc_horizon_steps.is_some() || params.mpc_px_cost.is_some() {
        if let Some(c) = gc.srbd_mpc_config() {
            let mut cfg = c.clone();
            if let Some(h) = params.mpc_horizon_steps {
                cfg.horizon_steps = h;
            }
            if let Some(w) = params.mpc_px_cost {
                // q_diag layout: [theta(3); p(3); omega(3); v(3); g].
                cfg.q_diag[3] = w;
            }
            eprintln!(
                "[srbd] horizon={} ({:.3}s)  q_diag[p_x]={}",
                cfg.horizon_steps,
                cfg.horizon_steps as f64 * cfg.dt_per_step,
                cfg.q_diag[3],
            );
            gc.set_srbd_mpc_config(cfg);
        }
    }
    if let Some(w) = params.fcm_taskspace_jv_weight {
        gc.set_task_space_joint_vel_weight(Some(w));
        eprintln!("[fcm] task-space joint-vel weight = {w:?}");
    }
    if params.fcm_warm_start {
        if let Some(c) = gc.full_centroidal_mpc_config() {
            let mut cfg = c.clone();
            cfg.warm_start = true;
            cfg.sqp_iterations = 1;
            gc.set_full_centroidal_mpc_config(cfg);
            eprintln!("[fcm] warm start, 1 SQP iteration");
        }
    }
    if params.fcm_grf_cost.is_some()
        || params.fcm_jointv_cost.is_some()
        || params.fcm_state_cost.is_some()
    {
        if let Some(c) = gc.full_centroidal_mpc_config() {
            let mut cfg = c.clone();
            if let Some(w) = params.fcm_grf_cost {
                for r in cfg.r_diag.iter_mut().take(12) {
                    *r = w;
                }
            }
            if let Some(w) = params.fcm_jointv_cost {
                for r in cfg.r_diag.iter_mut().skip(12) {
                    *r = w;
                }
                eprintln!("[fcm] r_diag joint_v = {w}");
            }
            if let Some(q) = params.fcm_state_cost {
                let blocks = [(0, 3), (3, 6), (6, 9), (9, 12), (12, 24)];
                for (bi, (a, b)) in blocks.iter().enumerate() {
                    for e in cfg.q_diag[*a..*b].iter_mut() {
                        *e = q[bi];
                    }
                }
                eprintln!(
                    "[fcm] q_diag: v_com={} omega={} pos={} euler={} joint_q={}",
                    q[0], q[1], q[2], q[3], q[4]
                );
            }
            gc.set_full_centroidal_mpc_config(cfg);
        }
    }
    if params.gait_mode == GaitMode::FullCentroidal
        && (params.fcm_horizon_steps.is_some()
            || params.fcm_dt_per_step.is_some()
            || params.fcm_sqp_iterations.is_some()
            || params.fcm_sparse_qp)
    {
        if let Some(c) = gc.full_centroidal_mpc_config() {
            let mut cfg = c.clone();
            if let Some(n) = params.fcm_horizon_steps {
                cfg.horizon_steps = n;
            }
            if let Some(dt) = params.fcm_dt_per_step {
                cfg.dt_per_step = dt;
            }
            if let Some(n) = params.fcm_sqp_iterations {
                cfg.sqp_iterations = n;
            }
            if params.fcm_sparse_qp {
                cfg.sparse_qp = true;
            }
            gc.set_full_centroidal_mpc_config(cfg);
        }
    }
    if params.gait_mode == GaitMode::FullCentroidal {
        if let Some(c) = gc.full_centroidal_mpc_config() {
            let i = c.centroidal_inertia_body;
            eprintln!(
                "[fcm] m={:.3}kg  mu={:.2}  fz_max={:.1}N  I=({:.5},{:.5},{:.5})  \
                 horizon={} dt={:.3} sqp={} sparse={}",
                c.mass_kg, c.friction_mu, c.max_normal_force,
                i[(0, 0)], i[(1, 1)], i[(2, 2)],
                c.horizon_steps, c.dt_per_step, c.sqp_iterations, c.sparse_qp,
            );
        } else {
            eprintln!("[fcm] config unavailable");
        }
    }
    if params.legged_control_parity {
        gc.set_legged_control_parity(true);
    }
    if params.dynamic_joint_q_reference {
        gc.set_dynamic_joint_q_reference(true);
    }
    if params.mpc_composite_inertia {
        let c = auto_detect_centroidal_mpc_config(&robot);
        let i = c.centroidal_inertia_body;
        // Start from whatever is already configured, not from a fresh
        // auto-detect. Rebuilding from scratch here silently discarded a
        // horizon of 30 and a p_x cost of 1000 that had been set earlier in
        // this same function, and the sweep reported three rungs of a ladder
        // as having no effect.
        let mut cfg = gc
            .srbd_mpc_config()
            .cloned()
            .unwrap_or_else(|| auto_detect_srbd_mpc_config(&robot));
        cfg.mass_kg = c.mass_kg;
        cfg.inertia_diag_body =
            Vector3::new(i[(0, 0)], i[(1, 1)], i[(2, 2)]);
        eprintln!(
            "[mpc] composite inertia: m={:.3}kg  I=({:.5},{:.5},{:.5})",
            cfg.mass_kg,
            cfg.inertia_diag_body.x,
            cfg.inertia_diag_body.y,
            cfg.inertia_diag_body.z,
        );
        gc.set_srbd_mpc_config(cfg);
        // Read it straight back, because a setter that silently does nothing
        // would look exactly like a controller that ignores its inertia.
        match gc.srbd_mpc_config_inertia() {
            Some(b) => eprintln!(
                "[mpc] read back: I=({:.5},{:.5},{:.5})", b.x, b.y, b.z
            ),
            None => eprintln!("[mpc] read back: NONE -- setter did not apply"),
        }
    }
    if let Some(k) = params.k_capture_s {
        gc.set_capture_point_gain(k);
    }

    // Foot link names for the WBC pipeline.
    let foot_links: [String; 4] = [
        DEFAULT_FOOT_LINKS[0].1.to_string(),
        DEFAULT_FOOT_LINKS[1].1.to_string(),
        DEFAULT_FOOT_LINKS[2].1.to_string(),
        DEFAULT_FOOT_LINKS[3].1.to_string(),
    ];
    let mg_total: f64 = robot.links.iter().map(|l| l.inertial.mass).sum::<f64>() * 9.81;
    let mut wbc_pipeline = WbcPipeline::new(&robot, foot_links);
    if let Some((formulation, cfg)) = params.misa_wbc_mode.clone() {
        wbc_pipeline = wbc_pipeline.with_wbc_solver(formulation, cfg);
    }
    wbc_pipeline.base_accel_coriolis = params.base_accel_coriolis;
    if params.flat_wbc_weights {
        let w = &mut wbc_pipeline.weights;
        w.floating_base_eom = 1.0;
        w.no_contact_motion = 1.0;
        w.base_accel = 1.0;
        w.swing_leg = 1.0;
        w.contact_force = 1.0;
        w.tau_gravity = 1.0;
    }
    if params.drop_tau_gravity {
        wbc_pipeline.weights.tau_gravity = 0.0;
    }
    if let Some(w) = params.contact_force_weight {
        wbc_pipeline.weights.contact_force = w;
        eprintln!("[wbc] contact_force weight = {w} (default 5.0)");
    }
    if let Some(w) = params.base_accel_weight {
        wbc_pipeline.weights.base_accel = w;
        eprintln!("[wbc] base_accel weight = {w} (default 200.0)");
    }
    if let Some((kp, kd)) = params.yaw_pd_gain {
        wbc_pipeline.yaw_pd_gain = (kp, kd);
        eprintln!("[wbc] yaw_pd_gain = ({kp}, {kd}) (default (0.0, 0.0))");
    }
    if let Some((kp, kd)) = params.attitude_pd_ablation {
        wbc_pipeline.roll_pd_gain = (kp, kd);
        wbc_pipeline.pitch_pd_gain = (kp, kd);
        eprintln!("[wbc] attitude_pd_ablation: roll/pitch PD = ({kp}, {kd}), GRF plan replaced by gravity split");
    }
    if params.f_min_stance_frac > 0.0 {
        let mg: f64 = robot.links.iter().map(|l| l.inertial.mass).sum::<f64>() * 9.81;
        wbc_pipeline.f_min_stance_n = params.f_min_stance_frac * mg / 4.0;
        eprintln!(
            "[wbc] f_min_stance = {:.2} N ({:.0}% of m*g/4 = {:.2} N)",
            wbc_pipeline.f_min_stance_n,
            100.0 * params.f_min_stance_frac,
            mg / 4.0,
        );
    }
    if params.wbc_real_mass_only || params.wbc_real_com_only || params.wbc_real_inertia_only {
        let c = auto_detect_centroidal_mpc_config(&robot);
        if params.wbc_real_mass_only {
            wbc_pipeline.mass_kg = c.mass_kg;
        }
        if params.wbc_real_com_only {
            wbc_pipeline.com_offset_body = c.com_offset_body;
        }
        if params.wbc_real_inertia_only {
            wbc_pipeline.centroidal_inertia_body = Some(c.centroidal_inertia_body);
        }
        eprintln!(
            "[wbc] partial: mass={} com={} inertia={}",
            params.wbc_real_mass_only,
            params.wbc_real_com_only,
            params.wbc_real_inertia_only,
        );
    }
    if params.wbc_real_inertia {
        // Same source the centroidal MPC config already uses: total mass,
        // aggregate CoM relative to the body root, and the angular block of
        // the composite-rigid-body inertia. Setting `centroidal_inertia_body`
        // also switches the pipeline onto the centroidal accel prediction,
        // which takes moment arms from the CoM instead of the root.
        let c = auto_detect_centroidal_mpc_config(&robot);
        wbc_pipeline.mass_kg = c.mass_kg;
        wbc_pipeline.com_offset_body = c.com_offset_body;
        wbc_pipeline.centroidal_inertia_body = Some(c.centroidal_inertia_body);
        let i = c.centroidal_inertia_body;
        eprintln!(
            "[wbc] real inertia: m={:.3}kg (was 9.000)  com_off=({:+.4},{:+.4},{:+.4})m  \
             I_diag=({:.5},{:.5},{:.5}) (was 0.07000,0.26000,0.24200)",
            c.mass_kg,
            c.com_offset_body.x, c.com_offset_body.y, c.com_offset_body.z,
            i[(0, 0)], i[(1, 1)], i[(2, 2)],
        );
    }

    // Joint names in the order `gc.joint_indices()` reports them, so the
    // replay CSV and the model agree without either side guessing.
    let replay_joint_names: Vec<String> = gc
        .joint_indices()
        .iter()
        .flatten()
        .map(|&ji| robot.joints[ji].name.clone())
        .collect();
    let mut replay_buf = String::new();
    if replay_out.is_some() {
        replay_buf.push_str("t,root_x,root_y,root_z,root_qw,root_qx,root_qy,root_qz");
        for n in &replay_joint_names {
            replay_buf.push_str(&format!(",{n}"));
        }
        // Measured per-foot normal force. A renderer cannot recover this from
        // pose: foot height says whether a foot is touching, not whether it
        // is carrying anything, and the two disagree by up to 0.24 of the
        // cycle on Walk's front pair -- which is precisely the foot that gets
        // unloaded. Writing the force out is cheaper than a proxy that
        // misrepresents the thing being compared.
        for (_, link) in DEFAULT_FOOT_LINKS.iter() {
            replay_buf.push_str(&format!(",fz_{link}"));
        }
        // The command as applied, and whether a push is being delivered.
        // Recorded rather than restated in the renderer: a schedule written
        // out twice is a schedule that will disagree with itself.
        replay_buf.push_str(",cmd_vx,cmd_vy,cmd_wz,push_fy");
        // The arm, and the opponent's free-joint pose when there is one.
        // Neither is in the twelve leg joints, and a replay of an arm attack
        // without the arm or the thing it is attacking is a replay of a
        // robot standing about.
        replay_buf.push_str(",arm_pitch_joint");
        if params.opponent.is_some() {
            replay_buf.push_str(",foe_x,foe_y,foe_z,foe_qw,foe_qx,foe_qy,foe_qz");
        }
        replay_buf.push('\n');
    }

    let n_steps = (params.total_time_s / params.dt).round() as usize;
    let burn_in_steps = (params.burn_in_s / params.dt).round() as usize;
    let mut samples: Vec<WbcSample> = Vec::with_capacity(n_steps);
    let mut v_hist: Vec<[f64; 3]> = Vec::with_capacity(n_steps);
    // Previous tick's IK targets, so the velocity path can differentiate them.
    let mut prev_targets = [0.0_f64; 12];
    let mut stance_mask = [true; 4];
    let mut reflex_active = [false; 4];
    // `hip_bias_gate`'s countdown: the sim time (seconds since t=0) at
    // which the gate closes again. Starts at -infinity so it reads as
    // "closed" before the first trigger.
    let mut hip_gate_open_until_s = f64::NEG_INFINITY;
    // Magnitude latched at the moment the gate last opened (see
    // `HipBiasGateCfg::bias_gain`'s doc comment).
    let mut hip_gate_bias_now = 0.0_f64;
    // Committed foothold plan per leg: (world_x, world_z_target), decided
    // once at the first tick of a swing and held fixed until that leg
    // returns to stance. `None` means "no plan yet for this swing" -- the
    // trigger to compute one, not an ongoing per-tick re-evaluation. See
    // `TerrainFootplanCfg`'s doc comment for why this replaced continuous
    // re-targeting.
    let mut planned_foothold: [Option<(f64, f64)>; 4] = [None; 4];
    let mut yaw_prev = 0.0_f64;
    let mut mpc_fx = 0.0_f64;
    let mut mpc_fz = 0.0_f64;
    let mut wbc_fx = 0.0_f64;
    // Host-computed PD for the torque path, paired with its joint index.
    let mut host_pd = [(0usize, 0.0_f64); 12];
    #[allow(unused_mut)]
    let mut respawn_pending = false;
    #[allow(unused_mut)]
    let mut respawn_inverted = false;
    // Seconds into the self-righting trajectory, or None when not
    // recovering, plus how long it has held an upright attitude. The hold is
    // what ends the recovery: a single upright sample happens mid-tumble
    // too, and handing back to the gait at that instant drops the robot
    // straight back over.
    #[allow(unused_mut)]
    let mut recover_t: Option<f64> = None;
    #[allow(unused_mut)]
    let mut recover_upright_s = 0.0_f64;
    #[allow(unused_mut)]
    let mut recover_slew: Option<crate::self_righting::Slew> = None;
    #[allow(unused_mut)]
    let mut recover_fast = false;
    #[allow(unused_mut)]
    let mut recover_tilt: Option<crate::self_righting::TiltEstimator> = None;
    // Which side the robot is lying on, latched once per recovery.
    #[allow(unused_mut)]
    let mut recover_mirror: Option<bool> = None;
    // Seconds into the arm attack, or None. Unlike the recovery this does
    // NOT take the joints away from the controller: it moves the front legs
    // through their nominal foot height, so the gait and the WBC keep the
    // robot up throughout and a failed attempt can just be walked out of.
    #[allow(unused_mut)]
    let mut attack_t: Option<f64> = None;
    #[allow(unused_mut)]
    let mut attack_now: Option<crate::attack::AttackCmd> = None;

    let render_hz = params.render_hz.unwrap_or(60.0).max(1.0);
    let render_decim = ((1.0 / render_hz) / params.dt).round().max(1.0) as usize;
    if params.live_viewer {
        eprintln!(
            "[viewer] render {render_hz:.0} Hz (every {render_decim} ticks = \
             {:.0} ms of sim per frame)",
            render_decim as f64 * params.dt * 1000.0,
        );
    }
    #[cfg(feature = "mujoco-viewer")]
    let mut viewer: Option<mujoco::viewer::MjViewer> = if params.live_viewer {
        let mut v = mujoco::viewer::MjViewer::launch_passive(sim.mj_model().clone(), 0)
            .expect("launch MjViewer");
        if let Some(live) = params.live_teleop.clone() {
            // Bindings live in `crate::teleop` so this and the RL demo
            // (examples/namiashi_rl_teleop.rs) cannot drift apart.
            // `_detached` (no `&mut MjData` param) since this only reads
            // egui's key state and writes `live` -- it never touches sim
            // state, so the cheaper detached path applies directly.
            use crate::teleop::{
                draw_hud, poll_body_lift_delta, poll_cmd, poll_friction_deltas, poll_gait,
                poll_arm_rate, poll_attack, poll_help_toggle, poll_level_toggle, poll_recover,
                poll_respawn,
                poll_swing_height_delta,
                SpeedEnvelope, BODY_LIFT_RANGE_M,
                FRICTION_RANGE, SWING_HEIGHT_RANGE_M,
            };
            v.add_ui_callback_detached(move |ctx| {
                let mut st = live.lock().unwrap();
                if let Some(g) = poll_gait(ctx) {
                    st.gait = g;
                }
                let dh = poll_swing_height_delta(ctx);
                if dh != 0.0 {
                    st.swing_height_m = (st.swing_height_m + dh)
                        .clamp(SWING_HEIGHT_RANGE_M.0, SWING_HEIGHT_RANGE_M.1);
                }
                if poll_help_toggle(ctx) {
                    st.show_help = !st.show_help;
                }
                st.arm_rate = poll_arm_rate(ctx);
                if let Some(inverted) = poll_respawn(ctx) {
                    st.respawn_requested = true;
                    st.respawn_inverted = inverted;
                }
                if poll_attack(ctx) {
                    st.attack_requested = true;
                }
                if let Some(fast) = poll_recover(ctx) {
                    st.recover_requested = true;
                    st.recover_fast = fast;
                }
                if poll_level_toggle(ctx) {
                    st.level_enabled = !st.level_enabled;
                }
                let dl = poll_body_lift_delta(ctx);
                if dl != 0.0 {
                    st.body_lift_m = (st.body_lift_m + dl)
                        .clamp(BODY_LIFT_RANGE_M.0, BODY_LIFT_RANGE_M.1);
                }
                let (dg, dc) = poll_friction_deltas(ctx);
                if dg != 0.0 {
                    st.ground_mu =
                        (st.ground_mu + dg).clamp(FRICTION_RANGE.0, FRICTION_RANGE.1);
                }
                if dc != 0.0 {
                    st.controller_mu =
                        (st.controller_mu + dc).clamp(FRICTION_RANGE.0, FRICTION_RANGE.1);
                }
                // Envelope follows the *requested* gait, so switching to
                // Crawl immediately re-scales what a full-deflection key
                // means rather than leaving Trot's ceiling in place.
                let env = SpeedEnvelope::for_gait(st.gait);
                st.cmd = poll_cmd(ctx, env);
                draw_hud(ctx, &st, env, "WBC / MPC", true);
            });
        }
        Some(v)
    } else {
        None
    };
    #[cfg(not(feature = "mujoco-viewer"))]
    if params.live_viewer {
        panic!("WbcParams::live_viewer requires building with --features mujoco-viewer");
    }
    // ~60 Hz render/sync cadence, independent of the (much finer) physics dt
    // -- rendering every physics tick would be thousands of frames/sec for
    // no visual benefit.
    let wall_start = std::time::Instant::now();
    #[cfg(feature = "mujoco-viewer")]
    let mut fps_meter = crate::teleop::FpsMeter::new();
    // Seed the live friction knobs from what the sim and the controller
    // were actually built with, so the HUD opens showing the truth rather
    // than a guess, and the first keypress steps off the real value.
    #[cfg(feature = "mujoco-viewer")]
    let (mut live_ground_mu, mut live_controller_mu) = {
        let g = sim.slide_friction();
        let c = wbc_pipeline.friction_mu;
        if let Some(live) = &params.live_teleop {
            let mut st = live.lock().unwrap();
            st.ground_mu = g;
            st.controller_mu = c;
        }
        (g, c)
    };

    for k in 0..n_steps {
        let t = k as f64 * params.dt;

        // Feed the attitude filter at the physics rate from the trunk IMU.
        // Every tick and unconditionally: a filter stepped only when someone
        // asks for its output is a filter with the wrong dt, and it now has
        // a second consumer (self-righting) that has no reason to know
        // whether the levelling happens to be configured.
        if let Some(imu) = sim.imu_readings(&robot).first() {
            ahrs.update_imu(imu.gyro, imu.accel, params.dt);
        }

        if k == 0 {
            gc.enable();
        }
        if k == burn_in_steps {
            gc.set_velocity_cmd(VelocityCmd {
                vx: params.cmd_vx,
                vy: params.cmd_vy,
                wz: params.cmd_wz,
            });
        }
        // Command schedule, applied on the tick its segment begins.
        if k >= burn_in_steps {
            if let Some(&(_, vx, vy, wz)) = params
                .cmd_schedule
                .iter()
                .rev()
                .find(|(t_from, ..)| t >= *t_from)
            {
                let now = gc.velocity_cmd();
                if (now.vx - vx).abs() > 1e-9
                    || (now.vy - vy).abs() > 1e-9
                    || (now.wz - wz).abs() > 1e-9
                {
                    gc.set_velocity_cmd(VelocityCmd { vx, vy, wz });
                }
            }
        }
        // Respawn, before anything else this tick reads the state: a
        // controller that has already sampled the old pose would spend a
        // tick driving toward it from the new one.
        #[cfg(feature = "mujoco-viewer")]
        {
            // Sim time, every tick and regardless of whether a viewer is
            // running. The HUD's copy is written at render cadence, which
            // means it never moves without a window -- and anything driving
            // this loop from outside, a test included, then has no clock but
            // the wall's. That non-determinism cost a debugging round.
            if let Some(live) = &params.live_teleop {
                let mut st = live.lock().unwrap();
                st.sim_time_s = t;
                if st.recover_at_sim_s.is_some_and(|at| t >= at) {
                    st.recover_at_sim_s = None;
                    st.recover_requested = true;
                }
                if st.attack_at_sim_s.is_some_and(|at| t >= at) {
                    st.attack_at_sim_s = None;
                    st.attack_requested = true;
                }
            }
            if let Some(live) = &params.live_teleop {
                let mut st = live.lock().unwrap();
                if std::mem::replace(&mut st.respawn_requested, false) {
                    respawn_pending = true;
                    respawn_inverted = st.respawn_inverted;
                }
                if std::mem::replace(&mut st.attack_requested, false) {
                    attack_t = Some(0.0);
                    eprintln!("[teleop] arm attack");
                }
                if std::mem::replace(&mut st.recover_requested, false) {
                    recover_t = Some(0.0);
                    recover_upright_s = 0.0;
                    recover_tilt = None;
                    recover_slew = None;
                    recover_mirror = None;
                    recover_fast = st.recover_fast;
                    eprintln!(
                        "[teleop] self-righting ({})",
                        if recover_fast { "fast" } else { "unhurried" }
                    );
                }
            }
            if respawn_pending {
                respawn_pending = false;
                recover_t = None;
                recover_upright_s = 0.0;
                recover_slew = None;
                attack_t = None;
                // Dropped in from 10 cm up, so the first contact is a short
                // fall rather than MuJoCo shoving the robot out of a
                // penetration it woke up inside.
                if respawn_inverted {
                    // Small, unlike the upright 0.10: `respawn_inverted`
                    // measures the pose and this is real clearance above the
                    // surface, not an offset from a feet-on-the-ground z.
                    sim.respawn_inverted(&mut robot, 0.03);
                } else {
                    sim.respawn(&mut robot, 0.10);
                }
                respawn_inverted = false;

                // The reference pose is "standing still with no gait
                // playing", so the CONTROLLER has to come back too --
                // restoring the body and leaving the gait mid-stride would
                // put the legs straight back into a step the robot is no
                // longer positioned for. `disable` returns the phase to the
                // cycle origin, resets the body integrator and zeroes the
                // command; `enable` starts it from there.
                gc.disable();
                gc.enable();

                // Everything else the loop carries across ticks and would
                // otherwise keep from before the reset: a differentiator
                // that spikes, a reflex or gate that thinks it is still
                // triggered, a foothold committed for a leg that has moved,
                // an attitude filter and per-leg ground heights estimated
                // somewhere else entirely.
                prev_targets = [0.0; 12];
                stance_mask = [true; 4];
                reflex_active = [false; 4];
                hip_gate_open_until_s = f64::NEG_INFINITY;
                hip_gate_bias_now = 0.0;
                planned_foothold = [None; 4];
                yaw_prev = 0.0;
                foot_fz_now = [0.0; 4];
                leg_h_filt = [0.0; 4];
                leg_h_seen = [false; 4];
                ahrs.reset();
                if let Some(ji) = arm_ji {
                    // The joint itself is back at its spawn angle; without
                    // this the PD target is still the pre-reset one and
                    // hauls it straight back.
                    arm_angle = robot.joint_positions[ji];
                    sim.set_position_target(ji, arm_angle);
                }
                eprintln!("[teleop] respawn: gait reset to standstill");
            }
        }

        // Arm pitch: integrate the held direction at the physics rate, so
        // the sweep speed does not depend on how fast the display is
        // managing to draw.
        #[cfg(feature = "mujoco-viewer")]
        if let (Some(live), Some(ji), Some((lo, hi))) = (&params.live_teleop, arm_ji, arm_range) {
            let rate = live.lock().unwrap().arm_rate;
            // The attack owns the arm while it runs; Y/G are ignored, the
            // same way W is during the creep.
            #[allow(unused_assignments)]
            if let Some(a) = attack_now {
                arm_angle = a.arm_rad.clamp(lo, hi);
                sim.set_position_target(ji, arm_angle);
            } else if rate != 0.0 {
                arm_angle = (arm_angle
                    + rate * crate::teleop::ARM_RATE_RAD_S * params.dt)
                    .clamp(lo, hi);
                sim.set_position_target(ji, arm_angle);
            }
            live.lock().unwrap().arm_angle_rad = arm_angle;
        }

        // Advance the attack before anything reads its command this tick.
        // The recovery wins if both are somehow live: one is a robot on its
        // back and the other assumes it is standing.
        #[cfg(feature = "mujoco-viewer")]
        {
            attack_now = None;
            if recover_t.is_some() {
                attack_t = None;
            } else if let Some(at) = attack_t {
                let plan = params.attack_params;
                if at > plan.total_s() {
                    attack_t = None;
                    eprintln!("[teleop] arm attack done");
                } else {
                    attack_now = Some(plan.at(at));
                    attack_t = Some(at + params.dt);
                }
            }
        }

        // Live teleop command, highest priority -- read every tick (not just
        // on change) since it can change between any two ticks.
        #[cfg(feature = "mujoco-viewer")]
        if k >= burn_in_steps {
            if let Some(live) = &params.live_teleop {
                let st = *live.lock().unwrap();
                // The attack drives the creep itself; the keys are ignored
                // for its duration so a held W does not walk the robot
                // through the opponent mid-move.
                let [vx, vy, wz] = match attack_now {
                    Some(a) => [a.cmd_vx, 0.0, 0.0],
                    None => st.cmd,
                };
                let now = gc.velocity_cmd();
                if (now.vx - vx).abs() > 1e-9
                    || (now.vy - vy).abs() > 1e-9
                    || (now.wz - wz).abs() > 1e-9
                {
                    gc.set_velocity_cmd(VelocityCmd { vx, vy, wz });
                }
                let gait_changed = st.gait != live_gait;
                let swing_changed = (st.swing_height_m - live_swing_height_m).abs() > 1e-9;
                if gait_changed || swing_changed {
                    // One `set_config` covers both: it swaps
                    // period/duty/step/swing AND the per-leg phase offsets.
                    // Rebuilding from the tuned row each time is idempotent
                    // when only the swing height moved.
                    //
                    // The phase generator keeps its current cycle_phase
                    // across the swap, so a gait switch mid-stride moves
                    // legs to their new offsets in one tick -- fine from a
                    // standstill (phase is frozen while the command is
                    // zero, all four feet in stance), a visible transient
                    // if done at speed.
                    let mut cfg = namiashi_tuned_gait_config(st.gait);
                    cfg.swing_height_m = st.swing_height_m;
                    gc.set_config(cfg);
                    cycle_period_s = gc.config().cycle_period_s;
                    live_gait = st.gait;
                    live_swing_height_m = st.swing_height_m;
                    if gait_changed {
                        eprintln!(
                            "[teleop] gait -> {:?} (T={:.3}s duty={:.2} \
                             max_step={:.3}m, tuned cmd_vx={:.3})",
                            st.gait,
                            cycle_period_s,
                            gc.config().duty_factor,
                            gc.config().max_step_length_m,
                            namiashi_tuned_cmd_vx(st.gait),
                        );
                    }
                    if swing_changed {
                        eprintln!(
                            "[teleop] swing height -> {:.3} m (tuned {:.3} m for {:?})",
                            st.swing_height_m,
                            namiashi_tuned_swing_height_m(st.gait),
                            st.gait,
                        );
                    }
                }
                if (st.ground_mu - live_ground_mu).abs() > 1e-9 {
                    sim.set_slide_friction_all(st.ground_mu);
                    live_ground_mu = st.ground_mu;
                    eprintln!("[teleop] ground mu -> {:.2}", st.ground_mu);
                }
                if (st.controller_mu - live_controller_mu).abs() > 1e-9 {
                    // Both consumers of the belief: the WBC QP's friction
                    // cone (what actually clips the commanded tangential
                    // force) and the MPC's own force planning. Setting one
                    // and not the other would leave the plan and the
                    // solver disagreeing about the same ground.
                    wbc_pipeline.friction_mu = st.controller_mu;
                    if let Some(mut mpc) = gc.srbd_mpc_config().cloned() {
                        mpc.friction_mu = st.controller_mu;
                        gc.set_srbd_mpc_config(mpc);
                    }
                    live_controller_mu = st.controller_mu;
                    eprintln!("[teleop] controller mu -> {:.2}", st.controller_mu);
                }
            }
        }
        // Push. Applied once, at its start tick; MuJoCo counts the duration
        // down itself.
        if let Some((t_push, force, dur)) = params.push {
            if k > 0 && t >= t_push && (t - params.dt) < t_push {
                sim.apply_external_force(&robot.root_link, force, [0.0; 3], dur);
            }
        }

        // Feed observed body velocity to the closed-loop generators, after
        // corrupting it the way the chosen `vel_obs` says. Everything
        // downstream -- the gait controller's feedback, the MPC's SRBD state
        // and the WBC -- sees this and only this.
        let v_true = sim
            .body_world_linear_velocity(&robot.root_link)
            .unwrap_or([0.0, 0.0, 0.0]);
        v_hist.push(v_true);
        let v_obs: [f64; 3] = match params.vel_obs {
            VelObs::Truth => v_true,
            VelObs::Zero => [0.0; 3],
            VelObs::Command => {
                // Body-frame command rotated into world by the true yaw.
                let (_, _, yaw_now) = robot.base_transform.rotation.euler_angles();
                let cmd = if k >= burn_in_steps {
                    (params.cmd_vx, params.cmd_vy)
                } else {
                    (0.0, 0.0)
                };
                [
                    yaw_now.cos() * cmd.0 - yaw_now.sin() * cmd.1,
                    yaw_now.sin() * cmd.0 + yaw_now.cos() * cmd.1,
                    0.0,
                ]
            }
            VelObs::Bias(bx, by) => [v_true[0] + bx, v_true[1] + by, v_true[2]],
            VelObs::Lag(secs) => {
                let back = (secs / params.dt).round() as usize;
                let idx = v_hist.len().saturating_sub(1 + back);
                v_hist[idx]
            }
        };
        let w_obs = sim
            .body_world_angular_velocity(&robot.root_link)
            .unwrap_or([0.0, 0.0, 0.0]);
        gc.set_body_state_observed(
            Vector3::new(v_obs[0], v_obs[1], v_obs[2]),
            Vector3::new(w_obs[0], w_obs[1], w_obs[2]),
        );
        // Feed the MPC's own body-pose estimate -- until now nothing called
        // this, so `body_state.world_yaw` inside the vendored MPC
        // (quadruped-gait) stayed pinned at its open-loop-integrated value
        // (identically 0.0 here, since cmd_wz==0 the whole run) regardless
        // of the real robot's yaw. The MPC uses that yaw to rotate each
        // foot's body-frame offset into world frame for its r_i x f_i
        // moment-arm balance (mpc_controller.rs's own comment: "any
        // integrated yaw makes the cross product mix frames and breaks
        // in-place rotation tracking") -- once a riser disturbs the real
        // yaw, every subsequent corrective GRF is computed against the
        // WRONG foot geometry, which can easily point the "correction"
        // the wrong way and amplify the drift instead of damping it. Using
        // ground-truth yaw/position here (matches `PoseSource::GroundTruth`
        // in gait.rs, already an established pattern in
        // tests/integration_walk.rs) isolates whether this wiring gap
        // alone explains the runaway drift, before swapping in a
        // proprioceptive estimator (Madgwick IMU fusion + leg odometry,
        // both already implemented -- see gait.rs's `PoseSource`) for a
        // real-hardware-deployable version.
        let yaw_obs = sim.body_world_yaw(&robot.root_link).unwrap_or(0.0);
        let pos_obs = sim.body_world_position(&robot.root_link).unwrap_or([0.0, 0.0, 0.0]);
        gc.set_body_pose_observed(yaw_obs, Vector3::new(pos_obs[0], pos_obs[1], pos_obs[2]));

        // Host-rate gate. On a host tick the controller runs and emits a new
        // command; between them the sim keeps whatever was last written,
        // which is what a driver does with a stale command. The gait
        // generator is advanced by the host period, not the physics one, so
        // the gait keeps real time.
        let host_decim = params
            .host_rate_hz
            .map(|hz| ((1.0 / hz) / params.dt).round().max(1.0) as usize)
            .unwrap_or(1);
        let host_tick = k % host_decim == 0;
        if gc.is_enabled() && host_tick {
            let host_dt = params.dt * host_decim as f64;
            // Per-leg nominal-stance offsets for this tick, ACCUMULATED.
            // Three things want to move the same `nominal_foot_body.z` --
            // live body height, proprioceptive levelling, terrain levelling
            // -- and each used to write it outright, so whichever ran last
            // silently erased the others. Summing here lets a crouch and a
            // levelling correction coexist, which is the combination anyone
            // driving the robot will actually reach for.
            let mut nom_off = [0.0_f64; 4];
            let mut nom_dirty = false;
            // Levelling is on unless a live session has switched it off;
            // a batch run has no toggle and gets whatever it configured.
            #[allow(unused_mut)]
            let mut level_on = true;

            // The attack's front-leg crouch and lift. Slots 0 and 1 are FL
            // and FR (LegId::ALL order), so this tilts the body nose-down
            // and back up without touching the rear pair.
            #[cfg(feature = "mujoco-viewer")]
            if let Some(a) = attack_now {
                if a.front_nom_off_m.abs() > 1e-9 {
                    nom_off[0] += a.front_nom_off_m;
                    nom_off[1] += a.front_nom_off_m;
                    nom_dirty = true;
                }
            }
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
