takarakasai/namiashi-runner2/(commit log)

2026-09-06 namiashi の機体固有部分を misa-runner から分ける
    misa-runner（旧 namiashi-runner のチェックアウト）から、この機体にしか無い
    ものを持ってくる: robots/namiashi.toml（配線・校正値・WBC のトルク上限
    1.6667 / 19.8 V なら 1.375）、models/namiashi、SBC と実機の立ち上げ・運用の
    doc/、dev-siblings.sh。src/main.rs は misa_runner::main_with(&[]) を呼ぶだけ
    （シリアル直結の Plant は misa-runner の組み込みなので Backend は差さない）。
    hayaashi-runner と同じ形。
    misa-runner は git 依存（ssh://git@github.com/takarakasai/misa-runner.git、
    branch namiashi2027）。Cargo.lock は最初の `car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
2026-09-06 misa-runner を https で取り、namiashi 固有の文書・試験を misa-runner から引き取る
    - Cargo.toml: misa-runner は https（公開リポジトリ。ssh:// は cargo の libgit2
    が ssh-agent 認証に失敗する環境がある）。Cargo.lock を追跡（misa-runner
    5228dec、namiashi2027）。SBC と PC で同じ依存をビルドできることのほうが大事
    - tests/model_consistency.rs: .misa と URDF サイドカーの整合（misa-runner から
    移動。models/namiashi の submodule を見る）。toml を dev-dependency に
    - README: 配線の UART 割り当て、未確定事項（初期姿勢・腕・歩幅）、
    「WBC / MPC の評価（MuJoCo）」（3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
2026-09-06 misa-runner を e05d685（namiashi 固有物を外した rev）に上げる
2026-09-06 MPC + WBC で MuJoCo をリアルタイムに操縦する構成を足す
    robots/namiashi_mpc_wbc.toml: robots/namiashi.toml（配線・校正値は同じ）に
    articara の詰め値（歩幅 0.145、周期 trot 0.320 / walk 0.500 / crawl 0.800、
    遊脚 0.04、max_vx 1.0）、controller = "mpc"、[wbc] enabled = true /
    output = "position" / torque_scale = 1.6667 を足したもの。README に
    --pilot keys + --viz（tcp/127.0.0.1:7447 で articara が購読）の手順とキー表。
    --viz 付きで 8 s の sim が壁時計 8.3 s、trot 0.50 で +2.39 m。
2026-09-06 misa-runner を e503c77（胴体高さの変更が全歩容で効く rev）に上げる
2026-09-06 README: 動画の撮り方（--height-script）と videos/ の無視
2026-09-06 README: o / p で WBC の出力と歩容コントローラを実行中に切り替える
2026-09-09 misa-runner を fcd6b6c（main）に上げ、branch の指定を外す
    namiashi2027 は main に統合され、push 先が main になったので既定ブランチを見る。
    基準姿勢（stance_*）・トルクからの接地推定・calib kt が入る。
2026-09-11 sim: articara の namiashi-wbc ブランチから特化分を移設する
    articara 側で長生きしていた namiashi-wbc ブランチを二つに分けた。どのロボット
    でも使える下回り（mjcf の escape hatch、respawn 系、シーン照明、StaircaseCfg、
    WBC の診断フラグなど）は articara main へ入れ（6e0a7fd）、namiashi と
    かわさきロボット競技大会のリングにしか意味のない側をこのリポジトリの sim/ に
    移した。
    - sim/src/: 競技リング + 関節ロック対戦相手（ring）、起き上がり軌道（V /
    Shift+V）、腕攻撃、テレオペのキーバインドと HUD、WBC 試験ハーネス
    - sim/examples/: n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
    [arm.stl, calf.stl, hip.stl, namiashi.urdf, namiashi_3p3_prop.urdf, thigh.stl, trunk.stl]
2026-09-12 sim: namiashi_rl_teleop に articara ライブ配信（--viz）を足す
    go2-runner の policy --sim と同じワイヤ契約で、planned（方策の q_des、
    ゴースト）と measured（MuJoCo 実測）を quadruped-gait の VizPublisher で
    配信する。送信の間引き・別スレッド化・seq の対付け・満杯時ドロップは
    あちらが持ち、この例は 12 関節の詰め替え（Isaac 型順 → slot 順）と胴体
    姿勢・接地（足裏力 5 N 閾値）だけを組む。feature viz =
    quadruped-gait/viz-pub で、viz 無しビルドは従来どおり（--viz 指定時は
    案内を出して止まる）。キー入力は従来どおり MjViewer 側。
    Co-Authored-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
2026-09-12 プロファイルを実測質量モデル namiashi_meas.misa に切り替える
    現物合わせ（2026-09-13）: リンク長は CAD どおり実測一致、質量は
    全体 3.295 kg / 脚 611 g（CAD 2.4 kg から差し替え）。サブモジュール
    namiashi_description に生成スクリプトごと入れた（1dc4b54）。可動域は
    calf ±2.697（校正実測）を採用、ゼロ姿勢は現状を正とする（ユーザ決定）。
2026-09-12 namiashi_description を実測 URDF/USD 込みへ上げる (31164d3)
2026-09-12 sim: 実測質量モデルの平地シーン MJCF を書き出す example
    go2_rl の sim2sim_namiashi_mujoco.py 用（motor_<joint> トルク
    アクチュエータ・trunk・timestep 5 ms・impratio 10/elliptic）。従来の
    既定シーンは WBC ハーネスの replay dump（階段入り・/tmp 置きで揮発）
    だった。
2026-09-13 機体名の表記を hayaashi に統一する（コメント）
2026-09-14 制御モードごとの歩行動画（walk 0.20）の結果表と、固定カメラで撮る注意を README に
    追従カメラだと無地の床で機体が止まって見えるので --cam-fixed で撮り直した。
    物理は同じ（前進・横ずれ・ヨーは前回と一致）。動画は videos/（追跡しない）。
2026-09-16 policy サブコマンド — RL 方策（misa-policy-runner namiashi 契約）を実機 / MuJoCo で回す
    - src/policy.rs: SerialPlant + runner::start_serial の立ち上げ → 立位へ 2 s
    ランプ → 50 Hz で位置目標のみ（WASD、傾き 45° で脱力、終了時は立位に戻す）
    - src/policy_sim.rs: misa-plant-mujoco（namiashi_meas.misa、5 ms × 4、kp25/kd0.5、
    --kp/--kv/--friction/--delay）、articara 配信
    - 既定 --wz-max 0.1（純旋回 0.2 はシムで転倒）
    - doc/policy_bringup.md: ベンチ → 床 の手順
    - 開発中は .cargo/config.toml（gitignore 済み）で misa-runner /
    misa-policy-runner をローカル path に patch。SBC では両方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
2026-09-18 policy --sim: SimOptions の新フィールド（関節種別ゲイン）は既定で埋める。Cargo.lock を push 済みの misa-runner / misa-policy-runner / articara / quadruped-gait に更新
2026-09-18 sim: 既定モデルを実測質量 namiashi_meas.misa に切り替える
    DEFAULT_MISA と「現在の挙動」を見る example 群（rl_teleop / ring ×2 /
    opponent / self_righting ×5）を 3p3_prop から実測配置版へ。wbc_walk.rs の
    prop-vs-hip 比較テストは仮説比較の記録なので明示ピンのまま据え置き。
    cross_model_check には meas を先頭行として追加（既定テスト 4 本は meas で
    全パス、全 example コンパイル確認済み）。
    cross_model_check の実測（meas 追加後）が現物合わせの効果をそのまま示す:
    起き上がり（3p3_prop で探索した軌道、18 姿勢×摩擦）
    gentle fast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
2026-09-18 policy_sim: ヨーを毎周期積算する（±π 巻き付きの計測バグ修正）
    最終 rpy の差を ±π に折っていたため、半回転を超えた旋回試行の報告値が
    符号ごと反転していた（go2_rl の Python sim2sim と同じバグ。あちらの
    2026-09-19 の修正と同型）。旋回バッテリの過去数値は要再読。
    [policy_sim.rs]
2026-09-18 policy: 契約世代を選択制に（--contract v15|v12、既定 v15）
    misa-policy-runner 0.4.0 の RefGaitCfg に対応。v15（種較正）が既定で、
    wz-max の既定も契約連動（v15 = 0.4、v12 = 0.1）。policy_1899 + v15 の
    Rust sim 実測: 純旋回 ±0.4 → 105/112%・0.2 → 98%・ドリフト ≤0.01 m/s・
    転倒なし（v12 経路は「0.2 で転倒」だった）。ONNX 入力幅は両世代 47 で
    自動判別できないため、旧チェックポイントには --contract v12 を明示。
2026-09-18 policy: v16 契約を既定に（--contract v16|v15|v12）
    misa-policy-runner 0.5.0 の RefGaitCfg::v16（前進のみ sg 1.4）。Rust sim
    実測（policy_4598）: 前進 0.2/0.3 → 110/100%・後退 68%・旋回 99/106%・
    転倒ゼロ。v15 実測（87/82%）からの前進改善は sg_fwd が効いた分で、
    契約を間違えるとそのまま失われる — 旧チェックポイントには --contract を
    明示すること。
2026-09-22 dump_flat_mjcf を機体非依存にする（--pose / --base-z）
    プレイブックの段 2 を別機体で回すのに要る。namiashi の関節名 13 個が直書き
    されていて、ANYmal C（`LF_HAA` 形式）では「joint missing: FL_hip_joint」で
    落ちていた。
    - トルクアクチュエータは**可動関節すべて**に付ける（名前を知らなくてよい）。
    - 立位姿勢は `--pose "NAME=RAD,..."`。無指定なら namiashi の既定を、
    **在る関節にだけ**当てる（1 つも無ければ明示エラー）。
    - `--base-z` で胴体の初期高さ（既定 0.235 は namiashi のまま）。
    namiashi の既定引数での出力は従来とバイト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
    [namiashi_dump_flat_mjcf.rs]
2026-09-23 policy: --contract v24（misa-policy-runner 0.8.0 の RefGaitCfg::v24）。実機比較の第 2 候補 s103@5500 を doc に
2026-09-23 policy: --record out.csv — 毎 tick の指令・実測 q/dq・IMU を CSV に（実機のステップ応答・現物合わせ用、sim でも可）
2026-09-24 policy: --heading-hold KP KI（misa-policy-runner 0.9.0 の HeadingServo）— 前進の横流れ −0.81 → −0.01 m/15 s（sim）
2026-09-24 doc: --record は実装済み（ベンチ手順）
2026-09-24 policy: デプロイ標準を v24 に切り替え（--contract の既定、sim 既定モデル、方位サーボ常用）
    体座標メトリクス + サーボ ON（旋回中も補正）の 25 ケースで v16 を全軸で上回る:
    平均 |追従誤差| 5.1pt 対 11.2pt、最大傾き 4.5° 対 6.0°、後退 111/105% 対 71/72%、
    旋回・複合ヨーとも 100%、転倒 0。v16 を維持していた理由（複合・旋回の劣位）は
    世界座標の計測アーティファクトとサーボの旋回ゲートで、どちらも解消した。
2026-09-24 doc: 立ち上げ手順の前提を v24 + サーボに更新、体座標メトリクスの注意を明記
